cheeky-smokey/FUJISOKU-SRAM-Utility/docs/hardware.md

# ハードウェア仕様 / 接続

この資料は次の出典とスケッチを突き合わせてまとめています。

| 区分 | 出典 |
|---|---|
| MCP23S17 とカードの結線 | note「cheekysmokey」配線の記事 <https://note.com/cheekysmokey/n/nef1ee2754b83>（2026-04-09） |
| FUJISOKU カードのピン配置 | 同ピン配置の記事 <https://note.com/cheekysmokey/n/n0525462640a3>（2026-01-31） |
| スロット（修理とエクステンダー化） | 同スロットの記事 <https://note.com/cheekysmokey/n/nd67f79d83b57> |
| Arduino ピン、制御定数、アクセス手順 | `FUJISOKU_SRAM_COPY/config.h`、`hardware.ino` |

> **注意**
> - 記事の値は本文テキストから読み取ったものです。結線は原文の表と照合してください。
> - **v3.0（ブランチ `wo62256`）で ch7 ポート B の割り当てを変えました**（§7）。62256 をやめ、B0〜B3 を制御線、B4〜B7 をカードの A16〜A19（F32〜F35）にしています。**この割り当ては実機ではまだ確かめていません**（v2.8 までの割り当ては main ブランチ）。
> - 記事に書かれていない項目（電源、MCP23S17 のアドレス、部品の型番など）は、基板の作者に確認しました（§13）。基板の回路図ではありません。

## 1. 部品の構成

| 区分 | 部品 | 用途 | スケッチの設定（`config.h`） |
|---|---|---|---|
| 必須 | Arduino UNO R4 | 制御、PC との USB シリアル | - |
| 必須 | MCP23S17 × 2 | カードのアドレス（ch6）とデータ・制御線（ch7） | - |
| 必須 | FUJISOKU カードのスロット | カードの接続（§12） | - |
| オプション | SD カードモジュール | 本体だけでの `*.bin` の保存・照合・書き戻し | `USE_SD`（既定 0） |
| オプション | 20×4 キャラクタ LCD（I2C） | 本体での状態・進捗の表示。同じ内容は Web アプリにも出る | `USE_LCD`（既定 1） |
| オプション | SPI SRAM（Microchip 23LC512、/CS = D6） | 本体だけでのコピー・比較の一時置き場（カード ⇄ SPI SRAM、SPI SRAM ⇄ SD） | `USE_SPI_SRAM`（既定 1。起動時に自動検出） |
| 配線 | カードの検出（F37 /CARD DET → D2） | カードが入っているか。無ければカードを使う操作を止める（§6.1） | `USE_CARD_DET`（既定 1） |
| 配線 | 電池電圧（F2 BATT-DET → A2、A2 と GND の間に 1 MΩ） | カードの電池電圧を表示し、1.70 V 以下で「少ない」、0.50 V 以下で「電池なし」と警告（§6.1） | `USE_BATT_DET`（既定 1） |

カードの吸い出し・書き込み・比較は Web アプリ（PC）でできるので、**必須なのは Arduino UNO R4、MCP23S17 × 2、スロットだけ**です。SD と LCD を 0 にすれば、外部ライブラリも要りません。

- `USE_SD` は既定で 0 です。SD のコードが入らず、SdFat ライブラリも要りません。SD のコマンドは `ERR DISABLED` を返します（§10）。SD カードモジュールをつないだら 1 にします。
- カードの検出と電池電圧は、Arduino に線を 1 本ずつ足すだけです（§6.1）。配線しない基板では `USE_CARD_DET` / `USE_BATT_DET` を 0 にしてください（`USE_CARD_DET` が 1 のまま D2 を配線しないと、いつも「カードなし」になります）。
- `USE_LCD` が 1 でも、起動時に LCD が I2C に応答しなければ LCD には何も送らずに動きます。LCD をつながないなら 0 にすると、LiquidCrystal I2C ライブラリも要りません。
- `USE_SPI_SRAM` が 1 でも、起動時に SPI SRAM が応答しなければ、SPI SRAM を使う操作は `ERR NOSPI` を返します（§9.1）。つながないなら 0 にすると、SPI SRAM のコードが入らず、`ERR DISABLED` を返します。

## 2. 全体接続図

ハードウェア接続図

- Arduino UNO R4 が SPI マスタです。PC とは USB シリアル（115200 bps）でつながり、Web アプリ（`webapp/FSRAM-Utility.html`）やシリアル端末から操作します。
- カードのアドレス・データ・制御線は **MCP23S17 を 2 個**（ch6 = アドレス、ch7 = データ + 制御）使った GPIO エキスパンダ経由で駆動します。
- 破線の箱（SD カード、LCD、SPI SRAM）はオプション部品です。v1 の TFT（ILI9341）とタッチ（XPT2046）は使いません。

### 2.1 電源と信号レベル

| 項目 | 内容 |
|---|---|
| 電源電圧 | **5 V**（単一電源） |
| レベル変換 | **不要**。Arduino UNO R4、MCP23S17、カード、SPI SRAM（23LC512 は 2.5〜5.5 V）、LCD はすべて 5 V 系 |
| カードの電源ピン | F3・F36 が Vcc（5 V）、F1・F38 が GND。それぞれカードの内部でつながっている（§5） |
| SD カード（オプション） | SD カード自体は 3.3 V なので、5 V で使えるモジュール（3.3 V レギュレータとレベル変換付き）を使う。作者の基板もこのモジュール |

### 2.2 回路図（KiCad）

ここまでの結線をまとめた KiCad の回路図が [hardware/kicad/](../hardware/kicad/) にあります（`.kicad_sch` と A3 の PDF）。結線は `check_netlist.py` でこの文書の表と照らし合わせてあります。パスコン（C1〜C3 0.1 µF）と C4（10 µF、カードの電源）は回路図だけに入れた推奨部品です。

回路図

### 2.3 シールド基板（KiCad、ガーバー付き）

Arduino UNO R4 に重ねるシールド基板（2 層、68.6 × 53.3 mm、部品はすべてスルーホール・DIP）が [hardware/kicad/shield/](../hardware/kicad/shield/) にあります。MCP23S17 × 2、23LC512（オプション）、BATT-DET のプルダウン、SD・LCD 用のピンヘッダが載り、62256 は載せていません。カードは、スロットユニット（U-BOX から外したスロット + 変換基板 + L 型ボックスヘッダ、§12.2）を J1 のキー付き MIL メスソケットに直接挿してつなぎます。ソケットのキーは奥（U1 側）で、逆向きには挿さりません。部品表と注文のしかたは [hardware/kicad/README.md](../hardware/kicad/README.md#シールド基板arduino-uno-r4-用) を見てください。基板の銅のつながりは `check_netlist.py --shield` でこの文書の表と照らし合わせてあります。

シールド基板（表）

## 3. Arduino ピン割り当て

| ピン | 定義名 | 接続先 | 備考 |
|---|---|---|---|
| D13 / D12 / D11 | - | SCK / MISO / MOSI（MCP23S17・SPI SRAM・SD で共用） | アクセスごとに `SPI.beginTransaction()`（4 MHz、モード 0） |
| A4 / A5 | - | LCD の SDA / SCL（PCF8574 バックパック、オプション） | `Wire`、I2C アドレス `LCD_I2C_ADDR`（既定 `0x27`） |
| D7 | `PIN_CS_SD` | SD カード /CS（オプション） | SD を使う処理のたびにマウントし直す（§10）。`USE_SD` が 0 でも High にしておく（SD モジュールを付けたままでも SPI を邪魔しない） |
| D6 | `PIN_CS_SPI_SRAM` | SPI SRAM /CS（オプション） | SPI SRAM の /CS はここだけ（§9.1）。`USE_SPI_SRAM` が 0 でも High にしておく |
| D5 | `PIN_MCP_RESET` | MCP23S17 /RESET（p18、2 個共通） | 起動時に 1 ms Low |
| D4 | `PIN_CS_MCP` | MCP23S17 /CS（p11、2 個共通） | 2 個はハードウェアアドレス（6 と 7）で区別する |
| D3 | `PIN_MCP_INT` | 未接続 | 入力にしているだけ。MCP23S17 の INT はつながず、割り込みは使わない |
| D2 | `PIN_CARD_DET` | カードの /CARD DET（F37） | 内蔵プルアップの入力。カードが入ると Low（§6.1） |
| A2 | `PIN_BATT_DET` | カードの BATT-DET（F2）。A2 と GND の間に 1 MΩ | アナログ入力（12 ビット、0〜5 V）。電池電圧を測る（§6.1） |
| D0、D1、D8、D9、D10、A0、A1、A3 | - | 空き | D8〜D10 は v1 では TFT とタッチに使っていた |

v2.2 まで定義だけあった D1（`CS_FSRAM_512`、未使用）は削除しました。

**SPI の設定について**: SdFat は SPI を高速なクロックに設定したまま戻しません（UNO R4 の `endTransaction()` は何もしない）。設定なしの `SPI.transfer()` だと、直前に SD を使ったときのクロックで MCP23S17（上限 10 MHz）に送ってしまうため、すべての MCP23S17 / SPI SRAM へのアクセスを `SPI.beginTransaction(4 MHz)` で囲んでいます。

## 4. MCP23S17 × 2

### 4.1 結線（記事より）

| MCP23S17 のピン | 接続 |
|---|---|
| p12 SCK / p13 SI / p14 SO | SPI の SCK / MOSI / MISO |
| p11 /CS | D4 |
| p18 /RESET | D5 |
| GPA0〜GPA7 | p21〜p28 |
| GPB0〜GPB7 | p1〜p8 |

- チップは **ch6（アドレス）と ch7（データ + 制御）** の 2 個です。
- スケッチは ch0〜ch7 の 8 チャネルすべてを初期化しますが、使うのは ch6 と ch7 だけです。存在しないチャネルへの書き込みは無視されます。
- A2:A0 ピンはチャネル番号と同じに設定します（ch6 = `110`、ch7 = `111`）。スケッチもこの前提で、作者の基板もこの設定です。
- 電源は VDD = 5 V、VSS = GND（§2.1）。INT ピンは使いません（D3 は未接続）。

### 4.2 オペコード

`0 1 0 0 A2 A1 A0 R/W`。チャネル（= ハードウェアアドレス）ごとに `config.h` のマクロで作ります。

| 項目 | 定義名 | 値 |
|---|---|---|
| 書き込み | `MCP_OP_WRITE(ch)` | `0x40 + ch × 2`（ch6 = `0x4C`、ch7 = `0x4E`） |
| 読み出し | `MCP_OP_READ(ch)` | `0x41 + ch × 2`（ch6 = `0x4D`、ch7 = `0x4F`） |

### 4.3 初期化（`mcp_init()`）

1. D5 を 1 ms Low にしてリセット（`setup()`）。
2. IOCON（BANK=0 のアドレス `0x0A`）へ `0x8C`（`MCP_IOCON_VALUE` = BANK + HAEN + ODR）を、オペコード `MCP_OP_WRITE(0)` = `0x40` と `MCP_OP_WRITE(4)` = `0x48` で 2 回書く。以後は **BANK=1** のレジスタ配置を使う。
   - HAEN が無効なあいだ、A2 ピンが High のチップは、オペコードの A2 ビットも 1 でないと応答しません（MCP23S17 の癖）。ch6 / ch7 は A2 = 1 なので `0x48` が要ります。
3. ch0〜ch7 すべてで OLAT_A/B = `0x00`、IODIR_A/B = 入力、GPPU_A/B = 全ビットプルアップ。
4. `bus_idle()`: ch7 IODIR_A = 入力、ch6 IODIR_A/B = 入力、**ch7 GPIO_B = `0x0F`（全制御線 非選択、A16〜A19 = 0）を書いてから** ch7 IODIR_B = 出力。
   - v1 は IODIR_B を先に出力にしていたため、全制御線が一瞬 Low になっていました。v2 は値を先に書くので、この瞬間はありません。

`bus_idle()` は、すべての処理の終わり（成功・失敗・中断とも）と、PC からの `rd` `wr` `fill` の後にも呼ばれます。待機中のアドレス・データ線は入力（プルアップ）で、制御線はすべて非選択です。

### 4.4 レジスタ（BANK=1）

| レジスタ | 定義名 | アドレス |
|---|---|---|
| IODIR A / B（1 = 入力） | `MCP_IODIR_A` / `MCP_IODIR_B` | `0x00` / `0x10` |
| GPPU A / B | `MCP_GPPU_A` / `MCP_GPPU_B` | `0x06` / `0x16` |
| GPIO A / B | `MCP_GPIO_A` / `MCP_GPIO_B` | `0x09` / `0x19` |
| OLAT A / B | `MCP_OLAT_A` / `MCP_OLAT_B` | `0x0A` / `0x1A` |
| IOCON（リセット直後、BANK=0） | `MCP_IOCON_BANK0` | `0x0A` |

### 4.5 チャネルの役割

| ch | 役割 | ポート A | ポート B |
|---|---|---|---|
| 0〜5 | 初期化のみ（入力 + プルアップ） | - | - |
| 6 (`MCP_CH_ADDR`) | アドレスバス | A0〜A7 | A8〜A15 |
| 7 (`MCP_CH_DATA` / `MCP_CH_CTRL`) | データ + 制御 | D0〜D7（読むときは入力、書くときは出力） | 制御線 + A16〜A19（常に出力、§7） |

## 5. FUJISOKU カードのピン配置（記事より）

38 ピン（F1〜F38）。方向はカードから見た向きです。

| ピン | 信号 | 方向 |
|---|---|---|
| F1 | GND | - |
| F2 | BATT-DET | 出力 |
| F3 | Vcc | - |
| F4 | /CE1 | 入力 |
| F5 | CE2 | 入力 |
| F6 | /WE | 入力 |
| F7 | /OE | 入力 |
| F8〜F15 | D0〜D7 | 双方向 |
| F16〜F23 | A0〜A7 | 入力 |
| F24〜F31 | A8〜A15 | 入力 |
| F32 | A16 | 入力 |
| F33 | A17 | 入力 |
| F34 | A18 | 入力 |
| F35 | A19 | 入力 |
| F36 | Vcc | - |
| F37 | /CARD DET | 出力 |
| F38 | GND | - |

- F3・F36（Vcc）と F1・F38（GND）は、それぞれカードの内部でつながっています。スロットからは 5 V と GND を供給します（§2.1）。
- 記事のピン配置表には F28 の行がありません。結線の記事では F28 = A12 です。
- カード容量ごとの未接続ピン（記事）: 128 KB は A17〜A19、256 KB は A18〜A19、512 KB は A19 が NC。
- このカードはシルバー編機のパターンプロセッサ（PE1）が使い、PE1 は A15 までを出力して A16〜A19 は接続しない、と記事にあります。
- カード型番は Fujisoku BS32D1-A（32 KB）と推定されています（記事は公式情報ではないと明記）。
- 本体だけの処理（コピー・比較・消去・SD）は **0x0000〜0x7FFF（32 KB）** を扱います。PC（Web アプリの `rd` / `wr`）からは、アドレス線 A0〜A19 の範囲 **0x00000〜0xFFFFF（1 MB）** まで読み書きできます（v3.0 から。v2.4〜v2.8 は A0〜A17 の 256 KB）。
- A18・A19（F34・F35）は v3.0 から ch7 の GPB6・GPB7 で駆動します。512 KB・1 MB のカードも全体を読み書きできます（v2.8 までは MCP につながず GND に固定し、先頭の 256 KB だけでした）。
- 32 KB のカードは A15 以上がつながっていない（NC）ので、0x8000 以降を読むと先頭と同じ内容が、書くと先頭が上書きされます。Web アプリは 32 KB を超えて書く前に警告します。

## 6. MCP23S17 とカードの結線

MCP23S17 とカードの結線図

| 信号 | カードのピン | MCP | ポート | MCP のピン | 方向（MCP 側） |
|---|---|---|---|---|---|
| `D0`〜`D7` | F8〜F15 | ch7 | GPA0〜GPA7 | 21〜28 | 双方向 |
| `A0`〜`A7` | F16〜F23 | ch6 | GPA0〜GPA7 | 21〜28 | 出力 |
| `A8`〜`A15` | F24〜F31 | ch6 | GPB0〜GPB7 | 1〜8 | 出力 |
| `CE2` | F5 | ch7 | GPB0 | 1 | 出力 |
| `/OE` | F7 | ch7 | GPB1 | 2 | 出力 |
| `/CE1` | F4 | ch7 | GPB2 | 3 | 出力 |
| `/WE` | F6 | ch7 | GPB3 | 4 | 出力 |
| `A16` | F32 | ch7 | GPB4 | 5 | 出力 |
| `A17` | F33 | ch7 | GPB5 | 6 | 出力 |
| `A18` | F34 | ch7 | GPB6 | 7 | 出力 |
| `A19` | F35 | ch7 | GPB7 | 8 | 出力 |

- ch7 ポート B は v3.0 の割り当てです（§7）。A0〜A15 とデータは記事と同じですが、制御線と A16・A17 の位置は記事とも v2.8 とも違います。
- データ線は D0〜D7 = ch7 の GPA0〜GPA7 の順です（D2 = GPA2、D3 = GPA3）。記事の配線表で D2 と D3 がどちらも GPA3 に見えるのは誤記で、スケッチどおりが正しいことを作者に確認しました。
- A18・A19（F34・F35）は ch7 の GPB6・GPB7 につなぎます（v3.0）。BATT-DET（F2）と /CARD DET（F37）は MCP を通さず、Arduino の A2 と D2 に直接つなぎます（§6.1）。
- 電源は 5 V で、レベル変換は要りません。カードの Vcc（F3、F36）に 5 V、GND（F1、F38）に GND をつなぎます（§2.1）。

### 6.1 カードの検出と電池電圧（Arduino に直接つなぐ）

| 信号 | カード | Arduino | 設定 | 動き |
|---|---|---|---|---|
| /CARD DET | F37 | D2（`PIN_CARD_DET`） | `USE_CARD_DET`（既定 1）、`CARD_DET_ACTIVE_LOW`（既定 1） | 内蔵プルアップの入力。カードが入ると Low |
| BATT-DET | F2 | A2（`PIN_BATT_DET`）。**A2 と GND の間に 1 MΩ** | `USE_BATT_DET`（既定 1）、`BATT_NONE_MV`（既定 500）、`BATT_LOW_MV`（既定 1700）、`BATT_ADC_FULL_MV`（既定 5000） | アナログ入力で電池電圧を測る |

**カードの検出（D2）**
- 50 ms 同じ値が続いたら抜き差しとみなし、PC に `E CARD 1` / `E CARD 0` を送ります。LCD の待機画面の 2 行目は `Card:OK` / `Card:NONE` になります。
- カードが無いとき、カードを使うコマンド（`rd f`・`wr f`・`copy`・`cmp`・`erase f`・`sd save f` など、1 文字コマンドの `R` `C` `X` `B` `L` `V` `e`）は `ERR NOCARD No card in the slot` を返します。
- 処理の途中で抜かれたら、3 回続けて「無い」と読んだところで止め、`ERR NOCARD Card removed at 0x....` を返します。バスは待機状態に戻します。
- 向きが逆（カードが入ると High）の基板では `CARD_DET_ACTIVE_LOW` を 0 にします。

**電池電圧（A2）**
- **A2 と GND の間に 1 MΩ の抵抗をつけます。** つけないと、電池が無いとき BATT-DET の線が浮き、カードの中の漏れ電流で 3〜4 V に見えます（作者の基板で、電池なしで 3.6 V と表示された）。抵抗に流れる電流は 3 µA ほどで、本体に挿しているあいだだけです。
- 作者の基板（1 MΩ 付き）での実測: **電池なし 0.24 V、新品の電池 2.75 V**。
- 0.5 秒ごとに 8 回測って平均します（12 ビット、0〜5 V）。50 mV 以上変わったときと、警告の境目をまたいだときに `E BATT <mV>` を送ります。
- **0.50 V（`BATT_NONE_MV`）以下は「電池なし」（No battery）**とみなします。LCD は `Bat:NONE!`、4 行目を `! No card battery` にします。Web アプリは「なし」と出し、画面の上に「カードに電池が入っていません」の警告を出します（本体に挿しているあいだは本体の電源で中身が保たれますが、抜くと消えます）。
- **1.70 V（`BATT_LOW_MV`）以下で「少ない」（Low battery）と警告**します。LCD は電圧の後ろに `!` を付け、4 行目を `! Card battery low` にします。Web アプリは画面の上に警告を出します。
- 2 つの判定電圧は `config.h` の先頭（`USE_BATT_DET` のすぐ下）で変えられます。`BATT_NONE_MV` は `BATT_LOW_MV` より小さくしてください（逆にするとビルドが止まります）。
- カードが無いときは測りません（表示は消え、`status` は `batt=-`）。挿してから 0.1 秒後に測り直します。
- 電圧の基準は UNO R4 の 5 V です。表示がテスターの値とずれるときは、5 V ピンをテスターで測った値を `BATT_ADC_FULL_MV` に入れると合います。

**電池の種類と A2 の測定値（実測）**

カードに入れる電池は 2 種類（CR2016、BR2325）あります。A2 の測定値（Arduino の測定電圧）と、テスターで測った電池の電圧を並べると、電池の種類ごとに原点を通る直線に乗り、テスターの値のほうが 13〜21 % 高く出ます。

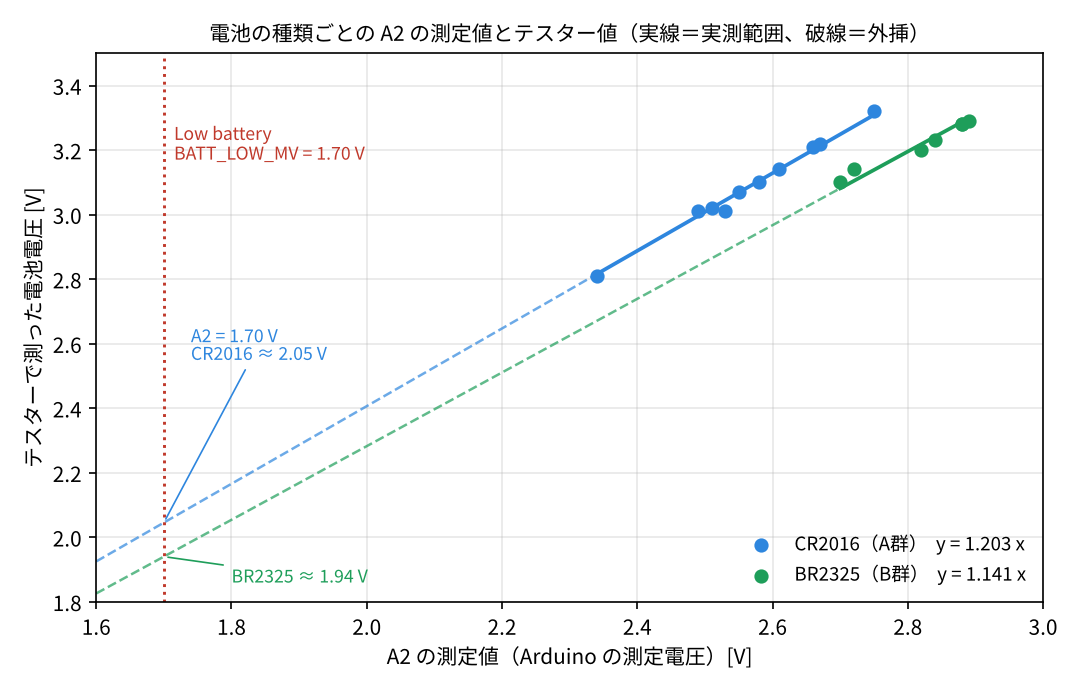
[picture p7: docs/images/battery-a2-vs-tester.png]
A2 の測定値とテスターで測った電池電圧の関係（CR2016 と BR2325）


**関係式**（x = A2 の測定値 [V]、y = テスターで測った電池電圧 [V]。原点を通る直線で近似）

| 群 | 電池 | A2 → テスター値 | テスター値 → A2 | 比（y ÷ x） | 実測との差（最大） | 点数 | 実測した x の範囲 |
|---|---|---|---|---|---|---|---|
| A 群 | CR2016 | **y = 1.203 x** | x = 0.831 y | 1.19〜1.21 | ±0.034 V | 10 | 2.34〜2.75 V |
| B 群 | BR2325 | **y = 1.141 x** | x = 0.876 y | 1.13〜1.15 | ±0.036 V | 7 | 2.70〜2.89 V |

- 「テスター値 → A2」の式は、「A2 → テスター値」の式の逆数です（1 ÷ 1.203 = 0.831、1 ÷ 1.141 = 0.876）。
- 実測した範囲は、A 群が B 群より低い電圧まで広がっています。B 群は 2.70〜2.89 V の狭い範囲だけなので、傾きの不確かさが大きく、低い電圧への外挿はそのぶんあやふやです。

**判定電圧の換算**（式からの外挿。実測した範囲の外にあるものは、実機で確かめていません）

| A2 の測定値 | CR2016（A 群）のテスター値 | BR2325（B 群）のテスター値 |
|---|---|---|
| 1.70 V（`BATT_LOW_MV`） | 約 2.05 V | 約 1.94 V |
| 1.50 V（以前の `BATT_LOW_MV`） | 約 1.80 V | 約 1.71 V |

| テスターで測った電池電圧 | CR2016（A 群）の A2 の測定値 | BR2325（B 群）の A2 の測定値 |
|---|---|---|
| 2.00 V | 約 1.66 V | 約 1.75 V |

実測値（A2 の測定値 → テスターの測定値、単位 V）:

| 電池 | A2 の測定値 → テスター値 |
|---|---|
| CR2016 | 2.34→2.81、2.49→3.01、2.51→3.02、2.53→3.01、2.55→3.07、2.58→3.10、2.61→3.14、2.66→3.21、2.67→3.22、2.75→3.32 |
| BR2325 | 2.70→3.10、2.72→3.14、2.82→3.20、2.84→3.23、2.88→3.28（2 回）、2.89→3.29 |
| カードの中身が消えていた状態 | 0.40→0.33、0.52→0.30、0.53→0.53 |

- 実測した範囲は、A2 の測定値で 2.34〜2.89 V です。それより低い範囲（Low battery の 1.70 V 付近）は測っていません。
- **Low battery（A2 の測定値 1.70 V 以下）は、テスターで測った電池の電圧では約 2 V（CR2016 で約 2.05 V、BR2325 で約 1.94 V）にあたります。** 数値は式からの外挿です。ここまで下がったら、電池の交換を促します（LCD の `!` と `! Card battery low`、Web アプリの警告）。
- **No battery（A2 の測定値 0.50 V 以下）は電池なしと判定できます。** カードの中身が消えていた 3 点は、A2 の測定値が 0.40〜0.53 V でした。0.52 V と 0.53 V は 0.50 V 以下に入らないため、「電池なし」ではなく「少ない」と判定されます。
- スケッチは A2 の測定値をそのまま表示し、電池の種類による補正はしません。
- テスターの値との差は電池の種類で比が違うため、`BATT_ADC_FULL_MV` では 2 種類の電池をそろえて合わせられません。

## 7. ch7 ポート B（制御線と A16〜A19）

v3.0（ブランチ `wo62256`）の割り当てです。62256 をやめて空いた B2 を /CE1 に回し、B4〜B7 をカードの A16〜A19 にしました。**実機ではまだ確かめていません**（PC 上のシミュレータとテストでは確認済み）。

| ビット | 信号 | 接続先 |
|---|---|---|
| B0 | CE2（High で選択） | F5 |
| B1 | /OE | F7 |
| B2 | /CE1 | F4 |
| B3 | /WE | F6 |
| B4 | A16 | F32 |
| B5 | A17 | F33 |
| B6 | A18 | F34 |
| B7 | A19 | F35 |

v2.8 までの割り当て（main ブランチ）は、B0 = CS2（62256 の /CS と共用）、B1 = /OE、B2 = 62256 の /OE、B3 = /WE、B4 = /CE1、B5 = 未使用、B6 = A16、B7 = A17 で、A18・A19 は GND に固定していました。この割り当ては作者の基板で動作確認済みです。v2.8 の基板を v3.0 で使うには、ch7 の GPB2・GPB4〜GPB7 の配線をつなぎ直す必要があります。

配線の記事の表（B0 = /CE1、B1 = CE2、B2 = /WE、B3 = /OE、B4/B5 = NC）とも違います。

SPI SRAM の /CS は Arduino の D6 につなぎます（MCP23S17 にはつながない）。

### 7.1 制御定数（`config.h`）

各ビットに名前を付け、状態ごとの値はそこから組み立てています。`hardware.ino` の `static_assert` で値を確かめています。

| ビット | 定義名 | 値 |
|---|---|---|
| B0 | `CTRL_CS2` | `0x01` |
| B1 | `CTRL_CARD_nOE` | `0x02` |
| B2 | `CTRL_CARD_nCE1` | `0x04` |
| B3 | `CTRL_nWE` | `0x08` |
| B4〜B7 | `CTRL_ADDR_HI` | `0xF0`（A16〜A19。`CTRL_ADDR_HI_SHIFT` = 12） |

| 状態 | 定義名 | 値 | 内容 |
|---|---|---|---|
| 待機 | `CTRL_IDLE` | `0x0F` | /CE1 = H、CE2 = H、/OE = H、/WE = H（非選択） |
| カード選択 | `CTRL_CARD_SELECT` | `0x0B` | /CE1 = L、CE2 = H |
| カード解放 | `CTRL_CARD_RELEASE` | `0x0E` | /CE1 = H、CE2 = L（1 バイトごとの後始末。CE2 も下げて二重に非選択にする） |

- 読み出しは選択値から `/OE`（B1）を、書き込みは `/WE`（B3）を落として作ります（例: カードの読み出し `0x0B & ~0x02` = `0x09`、書き込み `0x0B & ~0x08` = `0x03`）。
- A16〜A19 は `bus_select()` が `(address >> 12) & 0xF0` で B4〜B7 に重ねて出力します（0x00000〜0x0FFFF では 0）。A15 は ch6 の GPB7 です。

## 8. アクセスシーケンス

PC 上のシミュレータ（`test/sim`、`FSU_SIM_TRACE=1`）で記録した、`rd f 0x1234 2` と `wr f 0x1234 5A6B` の MCP23S17 へのアクセスです。**実機の測定ではありません。** どのアクセスも `SPI.beginTransaction()` で囲みます。

v2.3 では、1 バイトごとの手順（選択 → /OE や /WE のパルス → 解放）は v1 と同じ順のまま、次の 2 点で SPI の転送を減らしました（カード全域の読み込みは、シミュレータの時間で約 10.4 秒 → 約 7.3 秒）。

- バスの向き（IODIR）は、向きが変わるときだけ書く（`bus_set_dir()`。`bus_idle()` で待機に戻る）。
- 直前に自分で書いた制御値を OLAT_B から読み戻していたのをやめ、値を覚えておく。

### 8.1 読み出し（1 バイト 7 回。最初のバイトだけ向きの設定 3 回が先に入る）

| # | ch | レジスタ | 値 | 内容 |
|---|---|---|---|---|
| (1) | 6 | IODIR_A | `0x00` | A0〜A7 を出力（最初だけ） |
| (2) | 6 | IODIR_B | `0x00` | A8〜A15 を出力（最初だけ） |
| (3) | 7 | IODIR_A | `0xFF` | D0〜D7 を入力（最初だけ） |
| 1 | 6 | GPIO_A | `0x34` | A0〜A7 |
| 2 | 6 | GPIO_B | `0x12` | A8〜A15 |
| 3 | 7 | GPIO_B | `0x0B` | カード選択（+ A16〜A19） |
| 4 | 7 | GPIO_B | `0x09` | /OE = L（B1） |
| 5 | 7 | GPIO_A 読み | データ | データバスを読む |
| 6 | 7 | GPIO_B | `0x0B` | /OE = H |
| 7 | 7 | GPIO_B | `0x0E` | カード解放 |

### 8.2 書き込み（1 バイト 7 回。最初のバイトだけ向きの設定 3 回が入る）

| # | ch | レジスタ | 値 | 内容 |
|---|---|---|---|---|
| 1 | 7 | GPIO_A | `0x5A` | データを出力ラッチへ（**先に**値を決めてから出力にする） |
| (2) | 6 | IODIR_A / IODIR_B | `0x00` | アドレスを出力（最初だけ） |
| (3) | 7 | IODIR_A | `0x00` | D0〜D7 を出力（最初だけ） |
| 2 | 6 | GPIO_A | `0x34` | A0〜A7 |
| 3 | 6 | GPIO_B | `0x12` | A8〜A15 |
| 4 | 7 | GPIO_B | `0x0B` | カード選択 |
| 5 | 7 | GPIO_B | `0x03` | /WE = L（B3） |
| 6 | 7 | GPIO_B | `0x0B` | /WE = H（この立ち上がりで書き込まれる） |
| 7 | 7 | GPIO_B | `0x0E` | カード解放 |

処理の最後に `bus_idle()` が IODIR を入力に戻し、制御線を `0x0F` にします。

v2.2 までは「/WE = L → データを出す → /WE = H」の順で、/WE が Low のあいだに前のバイトの値が一瞬カードに書かれていました（最後に正しい値で上書きされるので結果は同じ）。v2.3 はデータを先に出すので、この途中の値はありません。

シミュレータでは、カードの SRAM は /WE の立ち上がりでデータを取り込むモデルにしてあり、「書き込み中にアドレスやデータが変わる」「/OE と /WE が同時に Low」「データバスの衝突」がないことをテストで確かめています。

## 9. SPI SRAM（オプション）

### 9.1 SPI SRAM（オプション、本体だけでの処理の一時置き場）

`config.h` の `USE_SPI_SRAM`（既定 1）で使います。カードの吸い出し・書き込み・比較は Web アプリ（PC）でできるので、SPI SRAM は本体だけでのコピー（`copy f s` / `R`、`copy s f` / `C`）・比較（`cmp` / `X`）と、SPI SRAM ⇄ SD（`S` / `W`）に使うだけです。

| 項目 | 値 |
|---|---|
| デバイス | Microchip 23LC512（512K ビット = 64 KB、2.5〜5.5 V。5 V で使う） |
| /CS | **Arduino D6**（`PIN_CS_SPI_SRAM`）。MCP23S17 にはつながない |
| SCK / MOSI / MISO | D13 / D11 / D12（MCP23S17・SD と共用） |
| アドレス | 16 ビット（2 バイト） |
| READ / WRITE | `0x03` / `0x02`（`SRAM23_READ` / `SRAM23_WRITE`） |
| モードレジスタ READ / WRITE | `0x05` / `0x01`（`SRAM23_RDMR` / `SRAM23_WRMR`） |
| モード | バイト `0x00`、ページ `0x80`、シーケンシャル `0x40`（電源投入時） |
| 利用範囲 | 本体だけの処理は 0x0000〜0x7FFF（32 KB）。PC からの `rd s` / `wr s` は 0x0000〜0xFFFF（64 KB） |
| 関数 | `read_spi_sram_byte()` / `write_spi_sram_byte()`、`spi_sram_read_mode()`、`spi_sram_init()` |
| コマンドの対象 | `s` |

- 起動時に `spi_sram_init()` で **SPI SRAM があるかを確かめます**。モードをバイト（`0x00`）→ シーケンシャル（`0x40`）と書いて、そのたびに読み戻します。チップが無いと MISO は張り付くか浮いているので、2 つとも読み戻せることはありません。最後はシーケンシャル（電源投入時と同じ）に揃えるので、Arduino だけリセットしても前の設定は残りません。
- 見つからなかったときは、SPI SRAM を使う操作が `ERR NOSPI SPI SRAM not found` を返し、`hello` は `spisram=none`、起動メッセージは `SPI SRAM none` になります。自己診断（`test`）は見つからなくても実行でき、そのときに探し直します（起動後につないだ場合も認識）。
- `USE_SPI_SRAM` を 0 にすると SPI SRAM のコードが入らず、対象 `s` と `R` `C` `X` `E` `S` `W` `T` は `ERR DISABLED` を返します。D6 は High のままです。
- 配線の確認は自己診断（Web アプリの「SPI SRAM・診断」、または `test`）でできます。モードレジスタが `40` なら応答あり、`FF` なら応答なし（/CS・MISO・電源を確認）です。`status` の `spi=` にも同じ値が出ます。
- v2.2 までの `config.h` は `MODE_RW_PAGE` と `MODE_RW_SEQ` の値が逆でした（データシートではページ `0x80`、シーケンシャル `0x40`）。v2.3 で直しました。

### 9.2 62256（v3.0 では使わない）

v2.8 までは、動作確認用の並列 SRAM 62256 をカードと同じバスにつなぎ、コマンドの対象 `p` として使えました（`USE_SRAM62256`）。v3.0（ブランチ `wo62256`）では、ch7 の GPB2 を /CE1 に、GPB4〜GPB7 を A16〜A19 に回すため 62256 をやめました。対象 `p` と `test p` は `ERR ARG` を返します。62256 を使う場合は main ブランチ（v2.8）を使います。

## 10. SD カード（オプション）

| 項目 | 内容 |
|---|---|
| 設定 | `USE_SD`（既定 0。使うときは 1） |
| ライブラリ | SdFat（Bill Greiman、v2 系）。`USE_SD` が 1 のときだけ必要 |
| 接続 | SPI（D13 / D12 / D11）、/CS = D7 |
| 用途 | PC を使わずに、カード ⇄ SD の保存・照合・書き戻し（Web アプリの「SD カード」タブ、または `sd` コマンド・`B` `L` `V`） |

`USE_SD` が 0 のときは、SD のコード（`storage.ino` と SD の処理）がコンパイルされません。`sd` `sdcheck` と 1 文字コマンドの `B` `L` `V` `S` `W` は `ERR DISABLED` を返し、LCD の待機画面は `SD:off`、Web アプリは SD のタブを隠します。

`USE_SD` が 1 のとき:

- SdFat（v2）を使い、ルートの `*.bin`（32,768 バイト）を扱います。既定のファイル名は `fujisoku.bin`。
- SD を使う処理を始めるたびにマウントし直すので、**処理の合間なら抜き差しできます**。起動時に SD が無くても止まりません。
- 待機中は 1.5 秒ごとにカードの応答を確かめ、抜かれたら LCD と PC に知らせます（`E SD 0`）。カードが無いときの `SD.begin()` は約 2 秒かかるため、挿したことの自動検出はしません。次の SD 処理か「SD カードを確認」（`sdcheck`）で認識します。
- UNO R4 の SdFat は `SD.end()` で共有の SPI ごと止めるので、スケッチは直後に SPI を動かし直します（MCP23S17 と SPI SRAM が使えなくなるのを防ぐ）。
- バックアップは一時ファイル `FSU_TMP.TMP` に書いてから名前を付け替えます。途中で失敗・中断・SD が抜けても、前のバックアップは残ります。

## 11. LCD（オプション、20 文字 × 4 行、I2C）

| 項目 | 値 |
|---|---|
| モジュール | HD44780 互換の 20×4 キャラクタ LCD + PCF8574 I2C バックパック |
| 接続 | 5V、GND、SDA = A4、SCL = A5 |
| I2C アドレス | `LCD_I2C_ADDR`（既定 `0x27`。作者の基板はこの値で動作確認済み。ほかのバックパックでは `0x3F` のこともある） |
| ライブラリ | LiquidCrystal I2C（Frank de Brabander）。`USE_LCD` が 0 なら不要 |
| 設定 | `USE_LCD`（既定 1）、`LCD_I2C_ADDR` |

- 起動時に `LCD_I2C_ADDR` へ I2C で呼びかけ、応答がなければ LCD は無いものとして、以後 LCD には何も送りません（UNO R4 の Wire は応答がなくても最大 0.1 秒で戻るので、起動は止まりません）。
- LCD の有無にかかわらず、本体は 20×4 の表示内容を持ち続けます。Web アプリは `lcd on` でその内容を受け取り、同じ画面を描きます。

表示内容は [specification.md §8](specification.md#8-表示lcd-と-web-アプリ) を参照してください。バックパックの半固定抵抗でコントラストを調整しないと文字が見えないことがあります。

## 12. スロット（記事より）

スロットの記事は、パターンプロセッサ（PE1）の壊れたスロットを修理し、リボンケーブルでつなぐ「エクステンダー」にした内容です。

- フジソク製のメモリスロットは 38 ピンで、もとのピン配列は ZIP。
- 使った部品: 汎用リボンケーブル用の 40 ピン 2 列ヘッダー（ピンを曲げて取り付け、不要なピンはカット）、ハーフピッチの 38 ピンヘッダー（壊れたスロットから抜いて修復・再組立）、秋月の 10 ピン 2.54 mm ピッチ（2×5）⇔ 1.27 mm ピッチ（1×10）変換基板、ケース用のユニバーサル基板。
- 1 番ピンの位置: 変換基板の表裏で、2 列ヘッダーの 1 番ピンが上段か下段かが決まる。PE1 の ZIP 配列に 2 列ヘッダーを付けると 1 番ピンは下段になる。記事は、変換基板の表裏を通常と逆にして下段を 1 番ピンにする方法を勧めています。
- ケーブルを延長しても、信号の遅れやノイズは問題にならなかったとあります。
- カードが壊れた場合は、リボンケーブル用ヘッダーに 62256 などの市販 SRAM を付けて代用できる、ただしアドレスデコードとバッテリーバックアップの回路が別に要る、とあります。

記事にはスロットから MCP23S17 への配線先は書かれていません。本ツールの結線は §6 です。

### 12.1 参考写真（作者の基板）

秋月電子の 10 ピン 2.54 mm ピッチ（2×5）⇔ 1.27 mm ピッチ（1×10）変換基板（上）と、それを 4 枚使ってスロットのピンを 40 ピン 2 列ヘッダーにつないだところ（下）です。

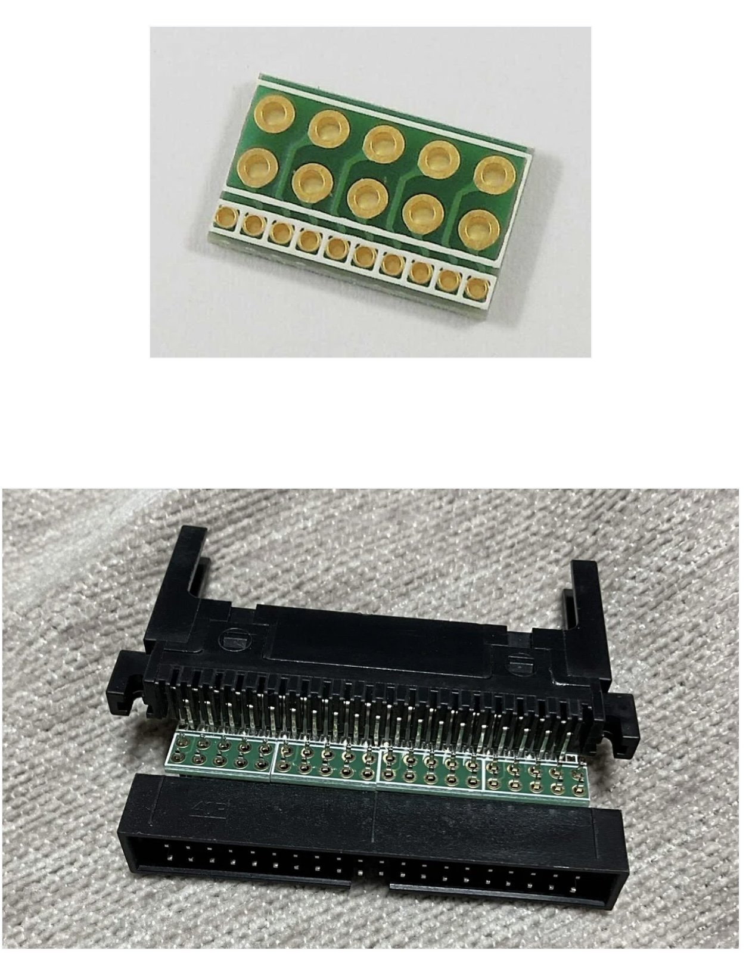
[picture p8: docs/images/slot-adapter-akizuki.jpg]
10 ピン 2.54 mm ⇔ 1.27 mm 変換基板と、スロットへの取り付け


ユニバーサル基板にスロットを固定し、カード（STITCH PATTERNS 32KB）を挿したところです。下の 40 ピン 2 列ヘッダーで MCP23S17 側へつなぎます（シールド基板では、L 型ボックスヘッダを付けたスロットユニットを J1 に直接挿します。§12.2）。

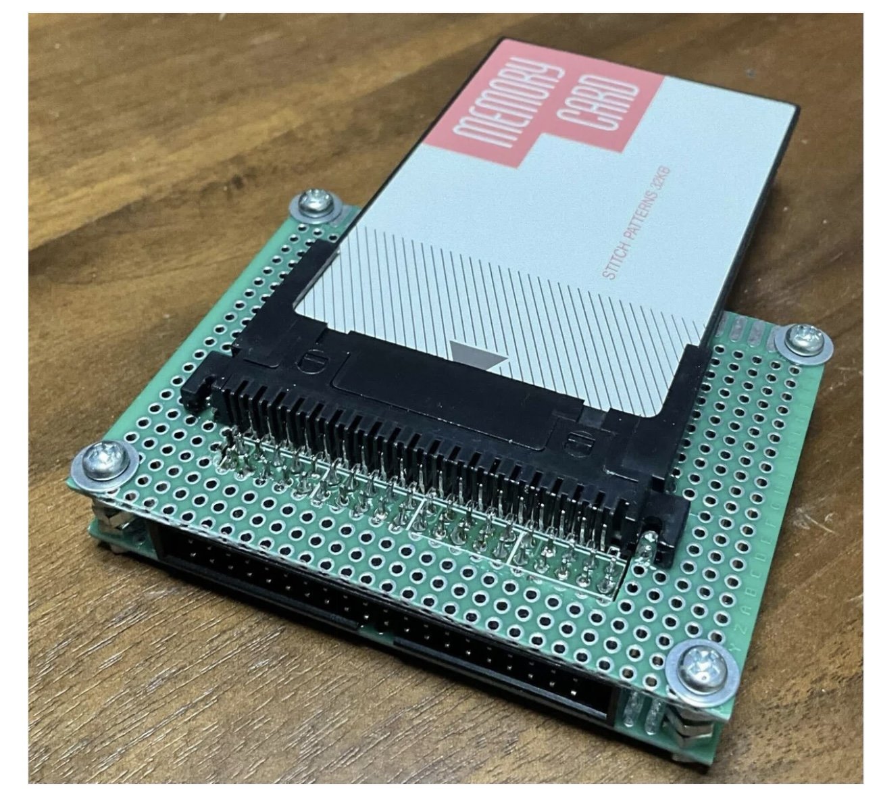
[picture p9: docs/images/slot-extender.jpg]
ユニバーサル基板に組んだスロットとカード


### 12.2 スロットユニット（作者に確認）

FUJISOKU のカードスロットは製造中止で手に入らないため、U-BOX から外したスロットを使います。スロットの足（ZIP 配列）を 1 列にそろえて、秋月電子の 2.54 mm（2×5）⇔ 1.27 mm（1×10）変換基板 4 枚の 1.27 mm の穴に挿し、2×5 の穴に **L 型（ライトアングル）のキー付きボックスヘッダ 2×20** を付けます。変換基板は表裏を通常と逆にして、ヘッダの下段（変換基板に近い列、偶数ピン）に F1 が来るようにします。

- **シールドにつなぐ**: シールド基板の J1（キー付き MIL メスソケット、キーは奥 = U1 側）に直接挿します。ボックスヘッダの切り欠きにソケットのキーが入るので、逆向きには挿さりません。挿した向きは、変換基板が手前（Arduino の電源ヘッダ側）、カードのラベル面が奥です。
- **U-BOX につなぐ**: U-BOX の CN2 に、足を ZIP 配列に曲げたボックスヘッダを付け、ストレートの 40 芯リボンケーブル（両端 IDC ソケット、1 番どうしがつながるもの）でつなぎます。CN2 の 1 番（F1）はボックスヘッダの 2 番（下段）に来るので、スロットユニットも 2 番 = F1 にしています。
- 切り欠き（キー）の位置は製品によって違うことがあります。買ったボックスヘッダとソケットで、正しい向きのときだけ挿さることを確かめてください。

ヘッダのピンとカードのピンの対応は次のとおりです。1.27 mm ピッチ 1 列のスロットのピンを、2.54 mm ピッチ 2 列に交互に振り分けた形です。

| ヘッダのピン | 1 | 2 | 3 | 4 | 5 | 6 | 7 | 8 | … | 35 | 36 | 37 | 38 | 39 | 40 |
|---|---|---|---|---|---|---|---|---|---|---|---|---|---|---|---|
| カードのピン | F2 | F1 | F4 | F3 | F6 | F5 | F8 | F7 | … | F36 | F35 | F38 | F37 | 空き | 空き |

奇数ピン 2k−1 = F2k、偶数ピン 2k = F2k−1（k = 1〜19）です。F34（A18、33 番）と F35（A19、36 番）は、v3.0 からシールド基板の U2（ch7）GPB6・GPB7 につながります。

## 13. 確認事項

記事に書かれていなかった項目も含め、次のとおり確定しています（基板の作者に確認）。

| 項目 | 結果 |
|---|---|
| 使用ボード | Arduino UNO R4 |
| 実機での動作 | Arduino UNO R4 と作者の基板で確認済み（v2.8。D2 のカード検出、A2 の電池電圧と電池なしの検出を含む）。**v3.0（ブランチ `wo62256`）の ch7 ポート B の新しい割り当てと A18・A19 は未確認** |
| A2 のプルダウン | A2 と GND の間に 1 MΩ。電池なしで 0.24 V、新品の電池で 2.75 V（実測） |
| 電池の種類 | CR2016 と BR2325。テスターで測った電池電圧と A2 の測定値の比（テスター値 ÷ A2 の測定値）は、CR2016 が約 1.20、BR2325 が約 1.14（実測。§6.1） |
| 電源電圧 | 5 V（§2.1） |
| レベル変換 | 不要（すべて 5 V 系） |
| カードの電源ピン | F3・F36 = Vcc（5 V）、F1・F38 = GND。カードの内部でそれぞれつながっている |
| MCP23S17 の数 | 2 個（ch6、ch7） |
| MCP23S17 の A2:A0 | チャネル番号と同じ（ch6 = `110`、ch7 = `111`）。スケッチどおり |
| D5 / D4 | MCP23S17 の /RESET（p18）/ /CS（p11） |
| D3（`PIN_MCP_INT`） | 未接続。割り込みは使わない |
| D2（`PIN_CARD_DET`） | カードの /CARD DET（F37）。カードの検出に使う（§6.1） |
| A2（`PIN_BATT_DET`） | カードの BATT-DET（F2）と、GND への 1 MΩ。電池電圧を測り、1.70 V 以下で「少ない」、0.50 V 以下で「電池なし」（§6.1） |
| カードのピン配置 | §5 |
| カードの F32〜F35（A16〜A19） | ch7（U2）の GPB4〜GPB7（v3.0。§6、§7）。カードは 1 MB まで |
| カードスロット | U-BOX から外したもの（FUJISOKU のスロットは製造中止）。変換基板 4 枚（表裏逆）と L 型のキー付きボックスヘッダ 2×20 でスロットユニットにする（§12.2） |
| スロットユニットの 40 ピン | 1 番 = F2、2 番 = F1（下段）、3 番 = F4、4 番 = F3 … 37 番 = F38、38 番 = F37。39・40 番は空き（§12.2） |
| シールドとの接続 | J1 のキー付き MIL メスソケット（基板用 40P、キーは奥 = U1 側）にスロットユニットを直接挿す |
| U-BOX との接続 | CN2 に足を ZIP 配列に曲げたボックスヘッダを付け、ストレートの 40 芯リボンケーブルでつなぐ。CN2 の 1 番（F1）がヘッダの 2 番 |
| データ線 | D0〜D7 = ch7 GPA0〜GPA7（D2 = GPA2、D3 = GPA3）。スケッチどおりで、記事の配線表の D2/D3 は誤記 |
| ch7 ポート B | B0 CE2、B1 /OE、B2 /CE1、B3 /WE、B4〜B7 A16〜A19（v3.0。§7） |
| SPI SRAM | Microchip 23LC512（64 KB）。/CS は Arduino D6（MCP23S17 にはつながない） |
| SD カードモジュール | 5 V で使えるもの（3.3 V レギュレータとレベル変換付き）。/CS は D7 |
| LCD | 20×4 キャラクタ LCD（I2C、オプション）。I2C アドレスは `0x27`（スケッチの既定値で動作確認済み）。TFT とタッチは使わない |
| 部品の区分 | 必須は MCP23S17 × 2 とスロット。SD カード、LCD、SPI SRAM はオプション（§1）。62256 は v3.0 では使わない |

まだ分からない項目はありません。
