cheeky-smokey/FUJISOKU-SRAM-Utility/docs/specification.md

# ソフトウェア仕様（スケッチ v3.0）

対象: `FUJISOKU_SRAM_COPY/`（`FSU_VERSION` = 3.0、ブランチ `wo62256`）。配線は [hardware.md](hardware.md)、PC との通信は [protocol.md](protocol.md)、Web アプリは [webapp.md](webapp.md) を参照してください。

## 1. 概要

FUJISOKU SRAM カード（基本は 32KB、0x0000〜0x7FFF。PC からは 1MB の 0xFFFFF まで）を、次の相手との間でコピー・照合します。

| 相手 | 操作する場所 |
|---|---|
| PC のファイル | Web アプリ（`rd` / `wr` で PC 側が処理し、本体は読み書きだけ）。**カードの吸い出し・書き込み・比較の基本はこれ** |
| SD カードの `*.bin`（オプション） | 本体（`sd save` / `sd load` / `sd verify`、1 文字コマンド `B` `L` `V`） |
| SPI SRAM（オプション、一時置き場） | 本体（`copy` / `cmp` / `erase`、1 文字コマンド `R` `C` `X` `E`） |

本体にボタンは無く、操作はすべて PC から行います。状態と進捗は 20×4 の画面に表示し、同じ内容を LCD（オプション）と Web アプリに出します。

## 2. ソース構成

Arduino IDE ではフォルダ内の `.ino` がタブとして開かれ、メインのファイルを先頭に、残りを名前順につないで 1 つのプログラムとしてビルドされます。

| ファイル | 内容 |
|---|---|
| `FUJISOKU_SRAM_COPY.ino` | ライブラリの読み込み（LCD はオプションに応じて）、グローバル変数、`setup()`、`loop()` |
| `card.ino` | カードの抜き差し（/CARD DET = D2、`E CARD`）と電池電圧（BATT-DET = A2、`E BATT`）。処理中にカードが抜かれたかの確認 |
| `config.h` | **オプション部品の選択**（§3）、設定値、ピン（`PIN_*`）、MCP23S17 のレジスタ（`MCP_*`）、制御線のビットと状態（`CTRL_*`）、SPI SRAM のコマンド（`SRAM23_*`） |
| `hardware.ino` | MCP23S17 のレジスタ読み書き（`mcp_read()` / `mcp_write()`）、`mcp_init()` / `bus_idle()`、バスの向きの管理、カード・SPI SRAM の 1 バイト読み書き、`spi_sram_init()` / `spi_sram_read_mode()` |
| `storage.ino` | SD カードの状態管理（マウント、生存確認、抜けの検出）、ファイル名の組み立て、一覧。`USE_SD` のときだけ |
| `operations.ino` | 処理の枠組み（開始・段階・進捗・終了・中断）と各処理（コピー、比較、消去、SD 保存・書き込み・照合、自己診断）。SD の処理は `USE_SD` のときだけ |
| `protocol.ino` | シリアルの行の受信、コマンドの振り分け、`rd` / `wr` / `fill`、PC 主導の表示（`ui`） |
| `lcd_ui.ino` | 画面（待機・進捗・結果）、LCD の検出と差分だけの書き換え、自作文字、PC への画面送信（`lcd`） |

## 3. 部品の構成とオプション

### 3.1 必須とオプション

| 区分 | 部品 | 設定 |
|---|---|---|
| 必須 | MCP23S17 × 2、FUJISOKU カードのスロット | - |
| オプション | SD カード（本体だけでの保存・照合・書き戻し） | `USE_SD` |
| オプション | 20×4 キャラクタ LCD（I2C） | `USE_LCD` |
| オプション | SPI SRAM（本体だけでのコピー・比較の一時置き場） | `USE_SPI_SRAM` |
| 配線 | カードの検出（F37 /CARD DET → D2） | `USE_CARD_DET` |
| 配線 | カードの電池電圧（F2 BATT-DET → A2） | `USE_BATT_DET` |

カードの吸い出し・書き込み・比較は Web アプリでできるので、SD カードと LCD はなくても使えます。既定の構成は SD カードなし（`USE_SD` = 0）、LCD と SPI SRAM はあり（どちらも起動時に探し、見つからなければ使わない）です。62256 は v3.0 で使わなくなりました（[hardware.md §9.2](hardware.md#92-62256v30-では使わない)）。

### 3.2 `config.h` のオプション

```c
#define USE_SD 0          // SD カード。1 で SD のコードを入れる (SdFat が要る)
#define USE_LCD 1         // 20x4 キャラクタ LCD (I2C)。0 で LCD のコードとライブラリを外す
#define USE_SPI_SRAM 1    // SPI SRAM。0 で SPI SRAM のコードを外す (1 でも見つからなければ使わない)
#define USE_CARD_DET 1    // カードの検出 (D2)。配線しない基板では 0
#define USE_BATT_DET 1    // カードの電池電圧 (A2、GND へ 1 MΩ)。配線しない基板では 0
```

| 設定 | 1 のとき | 0 のとき |
|---|---|---|
| `USE_SD` | 本体だけでの SD 保存・照合・書き戻し（§7）。起動時にカードが無くても、合間に抜き差ししても動く | SD のコード（`storage.ino`、SD の処理、`SdFat` の読み込み）を入れない。`sd` `sdcheck` と `B` `L` `V` `S` `W` は `ERR DISABLED`。`status` は `sd=-`、待機画面は `SD:off` |
| `USE_LCD` | 起動時に LCD を探し、見つかれば表示する（見つからなければ LCD には送らない） | LCD のコードを入れない。LiquidCrystal I2C と Wire を読み込まない |
| `USE_SPI_SRAM` | 起動時に SPI SRAM を探し（`spi_sram_init()`）、見つかれば対象 `s` と `R` `C` `X` `E` `S` `W` が使える。見つからなければそれらは `ERR NOSPI`。`test` は見つからなくても実行し、探し直す | SPI SRAM のコードを入れない。対象 `s` と `R` `C` `X` `E` `S` `W` `T` は `ERR DISABLED`。`status` は `spi=-` |
| `USE_CARD_DET` | D2 でカードの有無を見る。無ければカードを使う操作は `ERR NOCARD`、処理中に抜かれたら止める（§6.4） | いつもカードが入っているものとして扱う。`status` は `card=-` |
| `USE_BATT_DET` | A2 で電池電圧を測り、LCD と Web アプリに出す。`BATT_LOW_MV` 以下で「少ない」、`BATT_NONE_MV` 以下で「電池なし」と警告（§6.4） | 測らない。`status` は `batt=-` |

LCD の設定にかかわらず、本体は画面の内容を持ち続けるので、Web アプリには同じ画面が出ます。`hello` の応答（`lcd=20x4|none`、`sdcard=1|0`、`spisram=ok|none|off`）で、PC は構成を知ることができます。Web アプリは `sdcard=0` なら SD のタブを隠し、`spisram` が `ok` でなければ SPI SRAM の操作を隠します（`none` のときは自己診断だけ出す）。

SD と LCD を 0 にすると、外部ライブラリなしでビルドできます。

各設定は `#ifndef` で囲んであるので、ビルド時に `-DUSE_SD=0` のように外から変えることもできます（テストではこれを使っています）。

D7（SD の /CS）と D6（SPI SRAM の /CS）は、使わない設定でも出力・High にします。モジュールを付けたままでも、SPI の MISO を邪魔しません。

## 4. ビルド

| 項目 | 内容 |
|---|---|
| ボード | Arduino UNO R4（Minima / WiFi） |
| ライブラリ | `USE_SD` が 1 なら SdFat（Bill Greiman、v2 系）、`USE_LCD` が 1 なら LiquidCrystal I2C（Frank de Brabander）。どちらも 0 なら外部ライブラリは不要 |
| 標準ライブラリ | SPI（`USE_LCD` が 1 のときは Wire も） |

### 4.1 設定値（`config.h`）

| 定義 | 既定値 | 内容 |
|---|---|---|
| `USE_SD` | `0` | §3.2 |
| `USE_LCD` | `1` | §3.2 |
| `USE_CARD_DET` / `USE_BATT_DET` | `1` / `1` | §3.2 |
| `CARD_DET_ACTIVE_LOW` | `1` | /CARD DET はカードが入ると Low（逆の基板では 0） |
| `BATT_NONE_MV` | `500` | これ以下なら「電池なし」（No battery）[mV]。A2 の 1 MΩ で、電池が無いと約 0.24 V になる |
| `BATT_LOW_MV` | `1700` | これ以下なら「少ない」（Low battery）[mV]。`BATT_NONE_MV` より大きくする（逆ならビルドが止まる）。新品の電池は約 2.75 V |
| `BATT_ADC_FULL_MV` | `5000` | A2 の測定範囲 [mV]（UNO R4 の 5 V）。5 V ピンの実測値にすると電圧が正確になる |
| `LCD_I2C_ADDR` | `0x27` | LCD バックパックの I2C アドレス（`0x3F` の基板もある） |
| `RESULT_HOLD_MS` | `15000` | 結果画面を出しておく時間 |
| `SPI_BUS_HZ` | `4000000` | MCP23S17 / SPI SRAM の SPI クロック |
| `SD_ALIVE_CHECK_MS` | `1500` | 待機中に SD カードの応答を確かめる間隔 |
| `CHUNK_BYTES` | `64` | `rd` の 1 行、`wr` の最大バイト数 |
| `BLOCK_BYTES` | `256` | SD との読み書きの単位 |
| `SD_TMP_NAME` | `"FSU_TMP.TMP"` | バックアップ中の一時ファイル |

## 5. 起動と周期処理

### 5.1 `setup()`

1. `Serial.begin(115200)`（PC の接続は待たない）。
2. /CS ピン（D4、D6、D7）を出力・High にしてから `SPI.begin()`、MCP23S17 の /RESET パルス（D5 を 1 ms Low）。
3. `ui_begin()`: `USE_LCD` が 1 なら I2C で LCD を探し、見つかれば初期化して自作文字を登録する。起動画面を出す。
4. `mcp_init()`: MCP23S17 を BANK=1・HAEN にして全チャネルを初期化し、`bus_idle()`。
5. `spi_sram_init()`（`USE_SPI_SRAM` のときだけ）: SPI SRAM（/CS = D6）があるかを確かめ、モードを電源投入時と同じシーケンシャル（`0x40`）に揃える。無くても止まらない（[hardware.md §9.1](hardware.md#91-spi-sramオプション本体だけでの処理の一時置き場)）。
6. `card_begin()`: D2 を内蔵プルアップの入力にしてカードの有無を読み、カードがあれば A2 で電池電圧を測る。
7. `sd_mount()`（`USE_SD` のときだけ）: SD カードがあればマウント。無くても止まらない。
8. 待機画面を出し、`FUJISOKU SRAM Utility 3.0 ready (LCD 20x4, SD off, SPI SRAM ok, card in). ...` を送る（LCD が無ければ `LCD none`、`USE_SD` が 1 なら `SD on`、SPI SRAM は `ok` / `none`（見つからない）/ `off`（使わない設定）、カードは `in` / `none` / `-`（検出しない設定））。

### 5.2 `loop()`

`delay()` は使わず、次の 4 つを繰り返します。

| 関数 | 内容 |
|---|---|
| `proto_poll()` | シリアルから 1 行ずつ取り込んでコマンドを実行。PC 主導の表示が 8 秒止まったら表示を戻す |
| `ui_poll()` | 待機画面のカード・電池・SD・PC 表示の更新（0.2 秒ごと）、結果画面から待機画面への切り替え、`lcd on` のときの画面送信 |
| `card_poll()` | カードの抜き差し（50 ms のチャタリング除去、`E CARD 1/0`）と電池電圧（0.5 秒ごと、50 mV 以上の変化か警告の境目で `E BATT <mV>`） |
| `sd_idle_check()` | （`USE_SD` のときだけ）SD が使える状態なら 1.5 秒ごとに応答を確かめ、抜かれたら `E SD 0` |

## 6. 処理（`operations.ino`）

### 6.1 対象メモリ

| 対象 | 定義 | コマンドの文字 | 読み書き |
|---|---|---|---|
| FUJISOKU カード | `DEV_FUJISOKU` | `f` | `read_fujisoku()` / `write_fujisoku()` |
| SPI SRAM | `DEV_SPI_SRAM` | `s` | `read_spi_sram_byte()` / `write_spi_sram_byte()`（/CS = D6。`USE_SPI_SRAM` で、見つかったときだけ） |

`dev_read()` / `dev_write()` / `dev_name()` が対象を振り分けます。使えない対象（使わない設定、SPI SRAM が見つからない、カードが入っていない）は、コマンドを受けたときに `protocol.ino` の `dev_ready()` が `ERR DISABLED` / `ERR NOSPI` / `ERR NOCARD` ではじきます。

### 6.2 処理の枠組み

本体だけで行う処理は、すべて同じ流れです。

| 段階 | 関数 | PC への出力 | 画面 |
|---|---|---|---|
| 開始 | `op_start()` | - | 進捗画面（題名、内容） |
| 段階 | `op_phase()` | `S <段階>` | 2 行目 |
| 進捗 | `op_step()` | `P <済み> <合計>`（0.1 秒ごと） | 進捗バーと %（変わるたび）、アドレスと速度（0.5 秒ごと） |
| 終了 | `op_finish()` | `OK` / `NG` / `ERR` の 1 行 | 結果画面 |

- `op_step()` のたびに PC からの入力を確かめ、`!` があれば中断します（`ERR CANCEL cancelled`）。
- `op_finish()` は最初に `bus_idle()` を呼び、アドレス・データ線を入力に戻して制御線をすべて非選択にします。
- 処理中に届いた `!` 以外の入力は読み捨てます。

### 6.3 処理の一覧

| 処理 | 関数 | 画面の題名 | 内容 |
|---|---|---|---|
| コピー | `op_copy(src, dst)` | WRITE CARD / READ CARD / COPY | 1 バイトずつ読んで書く（任意の 2 つの対象） |
| 比較 | `op_compare(a, b)` | COMPARE | 全域を比べ、最初の 8 か所を `M` 行で、不一致の数と最初のアドレスを終了行で返す |
| 消去 | `op_erase(dev)` | ERASE | すべて `FF` |
| SD に保存 | `op_sd_save(dev, name)` | BACKUP / SAVE | 256 バイトずつ一時ファイルに書き、閉じてから名前を付け替える（SD の処理は 4 つとも `USE_SD` のときだけ） |
| SD から書き込み | `op_sd_load(dev, name, v)` | RESTORE / LOAD | 32,768 バイトちょうどのファイルだけ。`v` 付きなら続けて照合（進捗の合計は 65,536） |
| SD と照合 | `op_sd_verify(dev, name)` | VERIFY | 256 バイトずつ比べる |
| SD の一覧 | `op_sd_list()` | SD FILES | ルートの `*.bin` を最大 32 件 |
| SD の確認 | `op_sd_check()` | SD CHECK | マウントし直す |
| SPI SRAM の自己診断 | `op_test_spi()` | SPI SRAM TEST | `USE_SPI_SRAM` のときだけ。SPI SRAM を探し直してモードレジスタを読み（`T mode=40`。`FF` なら応答なし）、0x0000〜 と 0x7FF0〜 の 16 バイトに 2 種類の値を書いて読み戻す（元の値は戻す）。違いが 0 なら OK |

v1 との違い:
- `R` / `C` は書き込み前の消去をやめました（全域を上書きするため不要）。
- SD から書き込むとき、ファイルの大きさを確かめます（32,768 バイトでなければ書かない）。
- v1 の毎秒のメニュー表示、TFT の描画、使われていなかったコードは削除しました。

### 6.4 カードの抜き差しと電池電圧（`card.ino`）

| 項目 | 内容 |
|---|---|
| カードの有無 | D2（/CARD DET、内蔵プルアップ）。`CARD_DET_ACTIVE_LOW` が 1 なら Low = カードあり。50 ms 同じ値が続いたら `card_inserted` を変え、`E CARD 1` / `E CARD 0` を送る |
| カードが無いとき | `dev_ready()` が、カードを使うコマンドに `ERR NOCARD No card in the slot` を返す（`rd f` `wr f` `fill f` `copy` `cmp` `erase f` `sd save/load/verify f`、`R` `C` `X` `B` `L` `V` `e`） |
| 処理中に抜かれたら | カードを使うコマンドでは `op_needs_card` を立てる。`op_poll_cancel()` が 3 回続けて「無い」と読んだら中断し、`ERR NOCARD Card removed at 0x....`（PC 主導の `rd` / `wr` / `fill` は `ERR NOCARD Card removed`）。バスは待機状態に戻す |
| 電池電圧 | A2（BATT-DET）。12 ビットで 8 回測って平均し、`BATT_ADC_FULL_MV`（5000 mV）を満点として mV にする。0.5 秒ごと。カードが無いときは測らない（`batt_mv` = -1）。挿してから 0.1 秒後に測り直す |
| 知らせ方 | 前に送った値から 50 mV 以上変わったとき、または警告の境目（「少ない」「電池なし」）をまたいだときに `E BATT <mV>`。`status` の `batt=` はいつでも最新の値 |
| 電池なし | `batt_mv` が `BATT_NONE_MV`（500 mV）以下（`batt_none()`）。A2 と GND の間の 1 MΩ で、電池が無いと 0 V 近くになる（無いと漏れ電流で 3〜4 V に浮く）。LCD は `Bat:NONE!`、4 行目に `! No card battery`。Web アプリは「なし」と画面の上の警告 |
| 少ない | `batt_mv` が `BATT_LOW_MV`（1700 mV）以下（`batt_low()`。電池なしも含む）。LCD は電圧の後ろに `!`、4 行目に `! Card battery low`。Web アプリは画面の上に警告を出す |
| 電池の種類との関係 | `batt_mv` は A2 の測定値そのままで、電池の種類による補正はしない。テスターで測った電池電圧は、CR2016 が A2 の測定値の約 1.20 倍、BR2325 が約 1.14 倍。1.70 V 以下はテスターの値で約 2 V（CR2016 約 2.05 V、BR2325 約 1.94 V）にあたる（実測は [hardware.md](hardware.md) §6.1） |

## 7. SD カードの扱い（`storage.ino`、オプション）

この章は `USE_SD` が 1 のときの動作です。0 のときは §3.2 のとおり SD のコードがなく、`sd_state` は `SD_STATE_UNKNOWN` のままです。

| 状態 | 意味 |
|---|---|
| `SD_STATE_UNKNOWN` | 起動直後 |
| `SD_STATE_READY` | マウント済み |
| `SD_STATE_ABSENT` | 無い、または抜かれた |

- **SD を使う処理を始めるたびに `sd_mount()` でマウントし直します。** 処理の合間に抜き差し（差し替えを含む）しても、次の処理は新しいカードで動きます。
- 処理の途中で読み書きに失敗したら、カードが応答するか（`sectorCount()` が 0 でないか）を確かめ、応答すれば `SDERR`、しなければ `SDLOST` として終わります（`SDLOST` のときは状態を ABSENT にして `E SD 0`）。
- 待機中は READY のときだけ 1.5 秒ごとに応答を確かめます。ABSENT のときは確かめません（カードが無いと `SD.begin()` が約 2 秒止まるため）。挿したカードは、次の SD 処理か `sdcheck` で認識します。
- `SD.end()` は UNO R4 では共有の SPI ごと止めるので、直後に `spi_revive()` で動かし直します。
- 状態が変わると `E SD 0` / `E SD 1` を PC に送り、画面の表示も変わります。

## 8. 表示（LCD と Web アプリ）

LCD の表示

どの画面でも、4 行目の右下（20 文字目）に署名の © が出ます（自作文字）。4 行目に書く文字は 19 文字までです。

上の図は左上から、待機、処理中（SD に保存）、完了、不一致、SD カードなし、PC 主導の処理中です。

| 画面 | 1 行目 | 2 行目 | 3 行目 | 4 行目 |
|---|---|---|---|---|
| 待機 | `FUJISOKU SRAM v2.8` | `Card:OK / NONE` と電池電圧（例 `Bat:2.75V`。1.70 V 以下は後ろに `!`、0.50 V 以下は `Bat:NONE!`） | `SD:OK / NONE / off`、`PC:OK / --` | `Last:` 直前の結果。電池が 1.70 V 以下なら `! Card battery low`、0.50 V 以下なら `! No card battery`。右下に © |
| 処理中 | 題名と経過時間 | 段階 | 進捗バー（15 文字）と % | アドレス / 合計と速度（例 `0x3B00/8000  3.2k/s`）、右下に © |
| 結果 | 記号、題名、見出し（`DONE` `MISMATCH` `NO SD` `SD LOST` `CANCELED` など） | 説明（2 行に折り返し） | | 所要時間とエラーコード（例 `Time 00:02 NOSD`）、右下に © |

- 画面の内容は `lcd_shadow[4][20]` にいつも持っています。`lcd_row()` は前回の内容と比べて変わった文字だけを記録し、LCD があればその文字だけを送ります（I2C の LCD は 1 文字約 1 ms かかるため。32KB の保存全体で LCD に送るのは数百文字）。
- LCD の有無: `USE_LCD` が 1 なら、`ui_begin()` で `LCD_I2C_ADDR` に I2C で呼びかけ、応答がなければ `lcd_present` を false にして、以後 LCD には何も送りません。`USE_LCD` が 0 なら LCD のコードはありません。どちらの場合も `lcd_shadow` は更新され、`lcd` コマンドや Web アプリへの送信は同じように動きます。
- 進捗バーは CGRAM に登録した自作文字で、1 文字を 5 段階に分けます（15 文字 = 75 段階）。空き部分は文字 ROM の `_` です。チェック・バツの記号と署名の © も自作文字です（CGRAM 0〜4 = バー、5 = ©、6 = チェック、7 = バツ）。自作文字は文字コード `0x08`〜`0x0F` で書きます（`0x00`〜`0x07` と同じ文字で、文字列に 0 を入れずに済む）。
- 結果画面は 15 秒で待機画面に戻ります。次の処理が始まれば、すぐ進捗画面になります。
- 文字は ASCII だけを使います（LCD の文字 ROM の違いに左右されないように）。
- `lcd on` のあいだ、表示が変わるたび（最短 0.25 秒間隔）に `LCD <16進 160 桁>` を PC に送ります。Web アプリはこれで本体と同じ画面を描きます。

## 9. PC との通信（`protocol.ino`）

コマンドと応答の書式は [protocol.md](protocol.md) にまとめています。

- 受信した文字を 1 行（最大 199 文字）にためて、改行で実行します。長すぎる行は `ERR LINE` を返して捨てます。
- 1 文字だけの行は v1 の 1 文字コマンドとして扱います。
- `rd` `wr` `fill` のアドレスと長さは `range_ok()` で、対象ごとの大きさ（`dev_size()`: カード `CARD_MAX_SIZE` = 1MB、SPI SRAM 64KB）に収まるかを確かめます。`アドレス + 長さ` の桁あふれ（例: `rd f 0xFFFFFFF0 0x20`）も範囲外として `ERR RANGE` にします（v2.2 までは桁あふれで確認をすり抜け、A16/A17 が立った番地を読めてしまいました）。
- `!` は行に入れず、待機中なら捨てます（処理中は `op_poll_cancel()` が中断の合図として受け取る）。
- `USE_SD` が 0 のとき、SD のコマンドは `ERR DISABLED SD card is not used (USE_SD 0)` を返します。
- PC 主導の表示（`ui begin` 〜 `ui end`）の間は `op_session = 2` で、本体だけの処理は `ERR BUSY` になります。どのコマンドが届いても連絡があったものとして時刻を更新し、8 秒届かなければ画面に「PC LOST」を出して `E UI timeout` を送ります。

## 10. ファイル形式

| 項目 | 内容 |
|---|---|
| 中身 | カードの 0x0000 からをそのまま並べたもの（ヘッダなし） |
| 大きさ | 32,768 バイト。Web アプリでは 32KB〜1MB（SD は 32,768 バイトだけ） |
| SD 上の名前 | 英数字と `_` `-` の 16 文字まで + `.bin`（既定 `fujisoku.bin`） |
| PC 上の名前 | Web アプリの既定は `fujisoku_日付_時刻.bin`、書き込み前の自動保存は `backup_日付_時刻.bin`（32KB 以外は `_64KB` のように大きさが付く） |

## 11. データを守るための仕組み

| 場面 | 仕組み |
|---|---|
| SD への保存が途中で止まった（SD あり） | 一時ファイルに書き、最後に名前を付け替える。前のファイルは残る |
| サイズの違うファイル | 本体（`sd load`）は 32,768 バイトでなければ書き込まない。Web アプリは 32KB〜1MB のファイルだけを受け付ける |
| 32KB より大きいファイル | Web アプリは「書き込む大きさ」のボタン（32KB〜1MB、既定はファイルの大きさ）で書く範囲を選び、32KB より大きく書くときは警告して「先頭 32KB だけ」か「すべて」かを選ばせる（32KB のカードに 32KB を超えて書くと先頭が上書きされるため）。読み込みは既定 32KB |
| 上書きの前 | Web アプリは確認ダイアログを出し、既定で書き込む前のカードを PC に保存する |
| 読み違い | Web アプリは既定で 2 回読んで比べ、違えば保存しない |
| 書き込みの確かめ | `sd load ... v` と Web アプリの書き込みは、読み戻して照合する |
| PC が途中で止まった | 本体は 8 秒で PC 主導の表示を終える。カードへの書き込みは 64 バイト単位なので、途中までは書かれている（Web アプリの自動保存から戻せる） |
| カードの挿し忘れ | /CARD DET で検出し、カードが無ければカードを使う操作を止める（空の `FF` を「保存できた」と思い込まない）。処理中に抜かれても止める |
| 電池切れ・電池なし | 電池電圧を表示し、1.70 V 以下で「少ない」、0.50 V 以下で「電池なし」と警告。中身が消える前に保存できる |
| 配線の不安 | SPI SRAM は `test` で確かめられる（見つからないときも実行できる） |
| 範囲外のアドレス | PC からの `rd` `wr` `fill` は、桁あふれも含めて対象の範囲（カード 1MB、SPI SRAM 64KB）の外を断る |

## 12. 変更履歴

### 12.1 v3.0（62256 をやめ、A18・A19 を駆動。ブランチ `wo62256`）

| 区分 | 内容 |
|---|---|
| ハードウェア | ch7 ポート B の割り当てを変えた: B0 CE2、B1 /OE、**B2 /CE1**（v2.8 は B4）、B3 /WE、**B4〜B7 A16〜A19**（v2.8 は B6・B7 が A16・A17、A18・A19 は GND に固定）。v2.8 の基板は ch7 の GPB2・GPB4〜GPB7 の配線をつなぎ直す必要がある（[hardware.md §7](hardware.md#7-ch7-ポート-b制御線と-a16a19)） |
| 制御値 | 待機 `0x0F`、カード選択 `0x0B`、カード解放 `0x0E`。A16〜A19 は `(address >> 12) & 0xF0`。`static_assert` で確かめる |
| 62256 | `USE_SRAM62256`、対象 `p`、`test p` を削除。`p` は `ERR ARG`。`hello` から `sram62256=` を外した。起動メッセージから `62256 on/off` を外した |
| 範囲 | PC からのカードの `rd` `wr` `fill` を 1MB（0x00000〜0xFFFFF）にした。`hello` は `cardmax=1048576` |
| Web アプリ | 読み込む大きさに 512KB と 1MB を足した。書き込みに「書き込む大きさ」のボタン（32KB / 64KB / 128KB / 256KB / 512KB / 1MB、既定はファイルの大きさ。それ以外の大きさのファイルは「全体」）を足した。32KB より大きく書くときの「先頭 32KB だけ / すべて」のダイアログは残し、「すべて」は選んだ大きさを書く。32KB〜1MB のファイルを書き込める。62256 の表示と操作を外した |
| KiCad | 回路図とシールド基板を新しい割り当てにし、62256（U4）を外した。シールドは配線をやり直した（DRC エラー 0） |
| テスト | シミュレータを新しい割り当てと 1MB のカードに合わせた。62256 の構成をやめ、A16〜A19 のテストと、Web アプリで 1MB のカードを 256KB / 512KB / 1MB で読み書き・照合するテストを足した（66 件すべて成功） |
| 実機 | **まだ確かめていない** |

### 12.2 v2.8（電池の判定電圧。リリース版）

| 区分 | 内容 |
|---|---|
| 判定電圧 | No battery を 0.40 V → **0.50 V**（`BATT_NONE_MV` = 500）、Low battery を 2.00 V → **1.50 V** にしたあと、電池の実測（[hardware.md](hardware.md) §6.1）に合わせて **1.70 V**（`BATT_LOW_MV` = 1700）にした。1.70 V はテスターの値で約 2 V（CR2016 約 2.05 V、BR2325 約 1.94 V）にあたる |
| config.h | 2 つの判定電圧を `config.h` の先頭（`USE_BATT_DET` のすぐ下）に移し、どの電圧でどう判定するかを書いた。`BATT_NONE_MV` < `BATT_LOW_MV` でなければビルドが止まる（`static_assert`） |
| 通信 | `hello` は `battlow=1700 battnone=500` |
| 実機 | Arduino UNO R4 と作者の基板で動作を確認済み（Low battery を 1.50 V → 1.70 V にした変更は、まだ実機で確かめていない） |
| 公開 | v2.8 をリリース版にした（2026-11-08） |

### 12.3 v2.7（電池なしの検出）

| 区分 | 内容 |
|---|---|
| 配線 | A2 と GND の間に 1 MΩ を足す。電池が無いと BATT-DET が浮いて 3〜4 V に見えていた（実機で 3.6 V）。1 MΩ 付きの実測は、電池なし 0.24 V、新品の電池 2.75 V |
| 電池なし | `BATT_NONE_MV`（既定 400 mV）以下を「電池なし」とする（`batt_none()`）。LCD は `Bat:NONE!` と `! No card battery`、Web アプリは「なし」と警告 |
| Low battery | `BATT_LOW_MV` を 1000 mV から 2000 mV に上げた（新品の電池が 2.75 V と表示されるため。2.00 V 以下で「少ない」） |
| LCD の署名 | どの画面でも 4 行目の右下（20 文字目）に自作文字の © を出す。4 行目の文字は 19 文字までにした（進捗の `0x3B00/8000  3.2k/s`、結果の `Time 00:02 NOSD` など）。進捗バーの空き部分は文字 ROM の `_` にして、空いた自作文字を © に使った |
| 進捗の表示 | 書き込み + 照合（や 2 回の読み込み）を足したバイト数を合計として出していたため、32KB の書き込みが 64KB、64KB が 128KB に見えていた（実際に書くのはファイルの大きさだけ）。Web アプリのバイト数と LCD の進捗を段階ごとにした（`ui begin` を段階ごとに送り直す） |
| 実機 | Arduino UNO R4 と作者の基板で動作を確認済み（電池なし・Low battery の判定、LCD の署名、進捗の表示を含む） |
| 通信 | `hello` に `battnone` を追加。境目（0.40 V）をまたいだら `E BATT` を送る |

### 12.4 v2.6（カードの検出と電池電圧）

| 区分 | 内容 |
|---|---|
| 配線 | カードの /CARD DET（F37）を D2、BATT-DET（F2）を A2 に直接つなぐ |
| カードの検出 | `USE_CARD_DET`（既定 1）。カードが無いとカードを使う操作は `ERR NOCARD`。処理中に抜かれたら止めて `ERR NOCARD Card removed at 0x....`。抜き差しは `E CARD 1/0` |
| 電池電圧 | `USE_BATT_DET`（既定 1）。0.5 秒ごとに測り、`E BATT <mV>` で知らせる。1.00 V（`BATT_LOW_MV`）以下で LCD と Web アプリに警告 |
| 通信 | `hello` に `carddet` `battdet` `battlow`、`status` に `card` `batt` を追加 |
| 表示 | LCD の待機画面の 2 行目をカードと電池に、3 行目を SD・PC にした。Web アプリの「本体」欄にカードと電池、電池が少ないときは画面の上に警告 |
| Web アプリのファイル欄 | 選んだファイルを × で外せるようにした。同じ名前のファイルも選び直せる |
| 実機 | Arduino UNO R4 と作者の基板で動作を確認済み（D2 のカード検出、A2 の電池電圧を含む） |

### 12.5 v2.5（SPI SRAM をオプションに。リリース版）

| 区分 | 内容 |
|---|---|
| オプション | `USE_SPI_SRAM`（既定 1）を追加。1 のときは起動時に SPI SRAM を探し、見つからなければ SPI SRAM を使う操作は `ERR NOSPI`。0 なら SPI SRAM のコードを入れず `ERR DISABLED` |
| 検出 | `spi_sram_init()` がモードレジスタにバイト → シーケンシャルと書いて読み戻し、2 つとも合えば「あり」。自己診断（`test`）は見つからなくても実行し、探し直す |
| 通信 | `hello` に `spisram=ok|none|off`、起動メッセージに `SPI SRAM ok|none|off`。`status` の `spi=` は使わない設定で `-` |
| エラー | `ERR NOSPI` を追加。使わない設定の 62256（`p`）も `ERR ARG` から `ERR DISABLED` に変えた |
| Web アプリ | 本体の欄に SPI SRAM の状態を表示。使わない設定なら SPI SRAM の操作を隠し、見つからなければ自己診断だけ出す。カードの消去はいつでも使える |
| 実機 | Arduino UNO R4 と作者の基板で動作を確認済み（SPI SRAM のオプション化を含む） |
| 公開 | v2.5 をベータ版からリリース版にした（2026-11-07） |

### 12.6 v2.4（32KB より大きいカード）

| 区分 | 内容 |
|---|---|
| 範囲 | PC からの `rd` `wr` `fill` を対象ごとの大きさにした（カード 0x00000〜0x3FFFF = 256KB、SPI SRAM 64KB、62256 32KB）。本体だけの処理は 32KB のまま |
| 通信 | `hello` に `cardmax=262144` を追加。`D` 行のアドレスは 0x10000 以上で 5 桁 |
| Web アプリ | 読み込む大きさを 32KB（既定）/ 64KB / 128KB / 256KB のボタンで選ぶ。32KB〜256KB のファイルを書き込める。32KB より大きいときは「先頭 32KB だけ」か「すべて」かを警告で選ぶ。比較とメモリマップ・16 進表示も大きさに合わせる |
| 上限 | 256KB（A0〜A17）。A18・A19 は MCP につながっていない |

### 12.7 v2.3（コードレビューの結果）

| 区分 | 内容 |
|---|---|
| 配線 | SPI SRAM の /CS は D6 だけ。MCP23S17 ch7 B5 経由の /CS の読み書き・自己診断・起動時の設定を削除し、B5 は未使用にした |
| 不具合 | `rd` `wr` `fill` の範囲確認が `アドレス + 長さ` の桁あふれですり抜けていたのを修正（§9） |
| 不具合 | `config.h` の SPI SRAM のモード定数（ページとシーケンシャル）が逆だったのを修正 |
| 書き込みの順 | 「/WE = L → データ → /WE = H」を「データ → /WE = L → /WE = H」に変更。/WE が Low のあいだに前の値が一瞬書かれることがなくなった（[hardware.md §8](hardware.md#8-アクセスシーケンス)） |
| 速さ | 直前に書いた制御値の読み戻し（OLAT_B）をやめ、バスの向きは変わるときだけ設定する。1 バイトの MCP23S17 へのアクセスが 11〜12 回から 7 回になった |
| 読みやすさ | 制御線をビットごとの名前（`CTRL_*`）にして、状態の値をそこから組み立てた（値は v1 と同じで、`static_assert` で確認）。ピン（`PIN_*`）・MCP23S17（`MCP_*`）・SPI SRAM（`SRAM23_*`）の名前をそろえ、使っていない定数を削除。カードと 62256 の読み書きを共通の関数（`bus_read_byte()` / `bus_write_byte()`）にまとめた |
| 既定の構成 | `USE_SD` の既定を 0（SD カードなし）に変更。カードの保存は Web アプリで PC にできるため。SD を使うときは 1 にして SdFat を入れる |
| 整理 | 使われていなかった `sd_changed`、`ui_progress_begin()` の引数 `from_pc` を削除。TFT・タッチ時代のコメントを直した |
| 62256 の試験 | アドレス線の試験の説明（H 固定・L 固定）が実際の判定と合っていなかったので直した（判定そのものは同じ） |

## 13. 確かめたこと

実機（Arduino UNO R4 と作者の基板）での動作を v2.8 まで確認済みです。**v3.0（ブランチ `wo62256`）の新しい ch7 ポート B の割り当ては、まだ実機で確かめていません。**あわせて、次の自動確認を行っています（手順は [test/README.md](../test/README.md)）。

| 確認 | 内容 |
|---|---|
| ホストでのビルド | スケッチを Arduino IDE と同じ手順で 1 ファイルにまとめ、既定（SD なし）・SD あり・SD あり + `USE_LCD=0`・`USE_SPI_SRAM=0`（カード検出・電池も 0）の 4 通りを `-Wall -Wextra` で警告なしにビルド |
| 本物のライブラリでの型チェック | 本物の SdFat と LiquidCrystal I2C のヘッダに対して、4 通り（既定、SD・LCD あり、SD あり・LCD なし、最小構成（SD・LCD・SPI SRAM・カード検出・電池なし））すべて警告・エラーなし。使わない部品のライブラリは渡さずに確認（既定は SdFat なし、SD・LCD なしは外部ライブラリなし） |
| シミュレータでの動作 | MCP23S17 ×2（BANK・HAEN・A2 の癖まで）、カード（32KB〜1MB）、23LC512、SD カード（抜き差し・差し替え）、HD44780 LCD（あり・なし）を再現したシミュレータで、ファームウェア 30 件、表示 9 件、Web アプリ 27 件の自動テストがすべて成功 |
| バスの使い方 | ファームウェアと表示のテストで、トランザクション外の SPI 転送、MCP の上限を超えるクロック、バス衝突、書き込み中のアドレス・データの変化、2 つ以上の /CS が同時に Low、LCD の CGRAM への誤書き込み、LCD が無いのに LCD へ送ること、が 0 件。`USE_SD=0` では SD カードへのアクセスが 0 件 |
| A16〜A19 | 1MB のカードで 0x10000 / 0x20000 / 0x40000 / 0x80000 / 0xC0000 / 0xFFFFF が別の場所になり、256KB のカードでは 0x40000 が先頭と重なることを確認。読み書きのあと ch7 GPB は待機値 `0x0F` |

## 14. 注意点

- `USE_LCD` が 1 で LCD が無い場合、起動時の検出に最大 0.1 秒かかるだけで、ほかの動作には影響しません。LCD があるのに表示されないときは、`LCD_I2C_ADDR` を `0x3F` にするか、バックパックの半固定抵抗でコントラストを調整してください。
- 処理の速さは実機で測っていません。シミュレータの見積もりでは、32KB の読み込みが 7 秒前後です（v2.2 は 10 秒前後。[hardware.md §8](hardware.md#8-アクセスシーケンス)）。
- SPI SRAM の /CS は D6 です（MCP23S17 にはつながない）。
- Web アプリは Web Serial を使うため、PC の Chrome / Edge が必要です（スマートフォンは不可）。
