cheeky-smokey/FUJISOKU-SRAM-Utility/hardware/kicad/FUJISOKU_SRAM_Utility.pdf

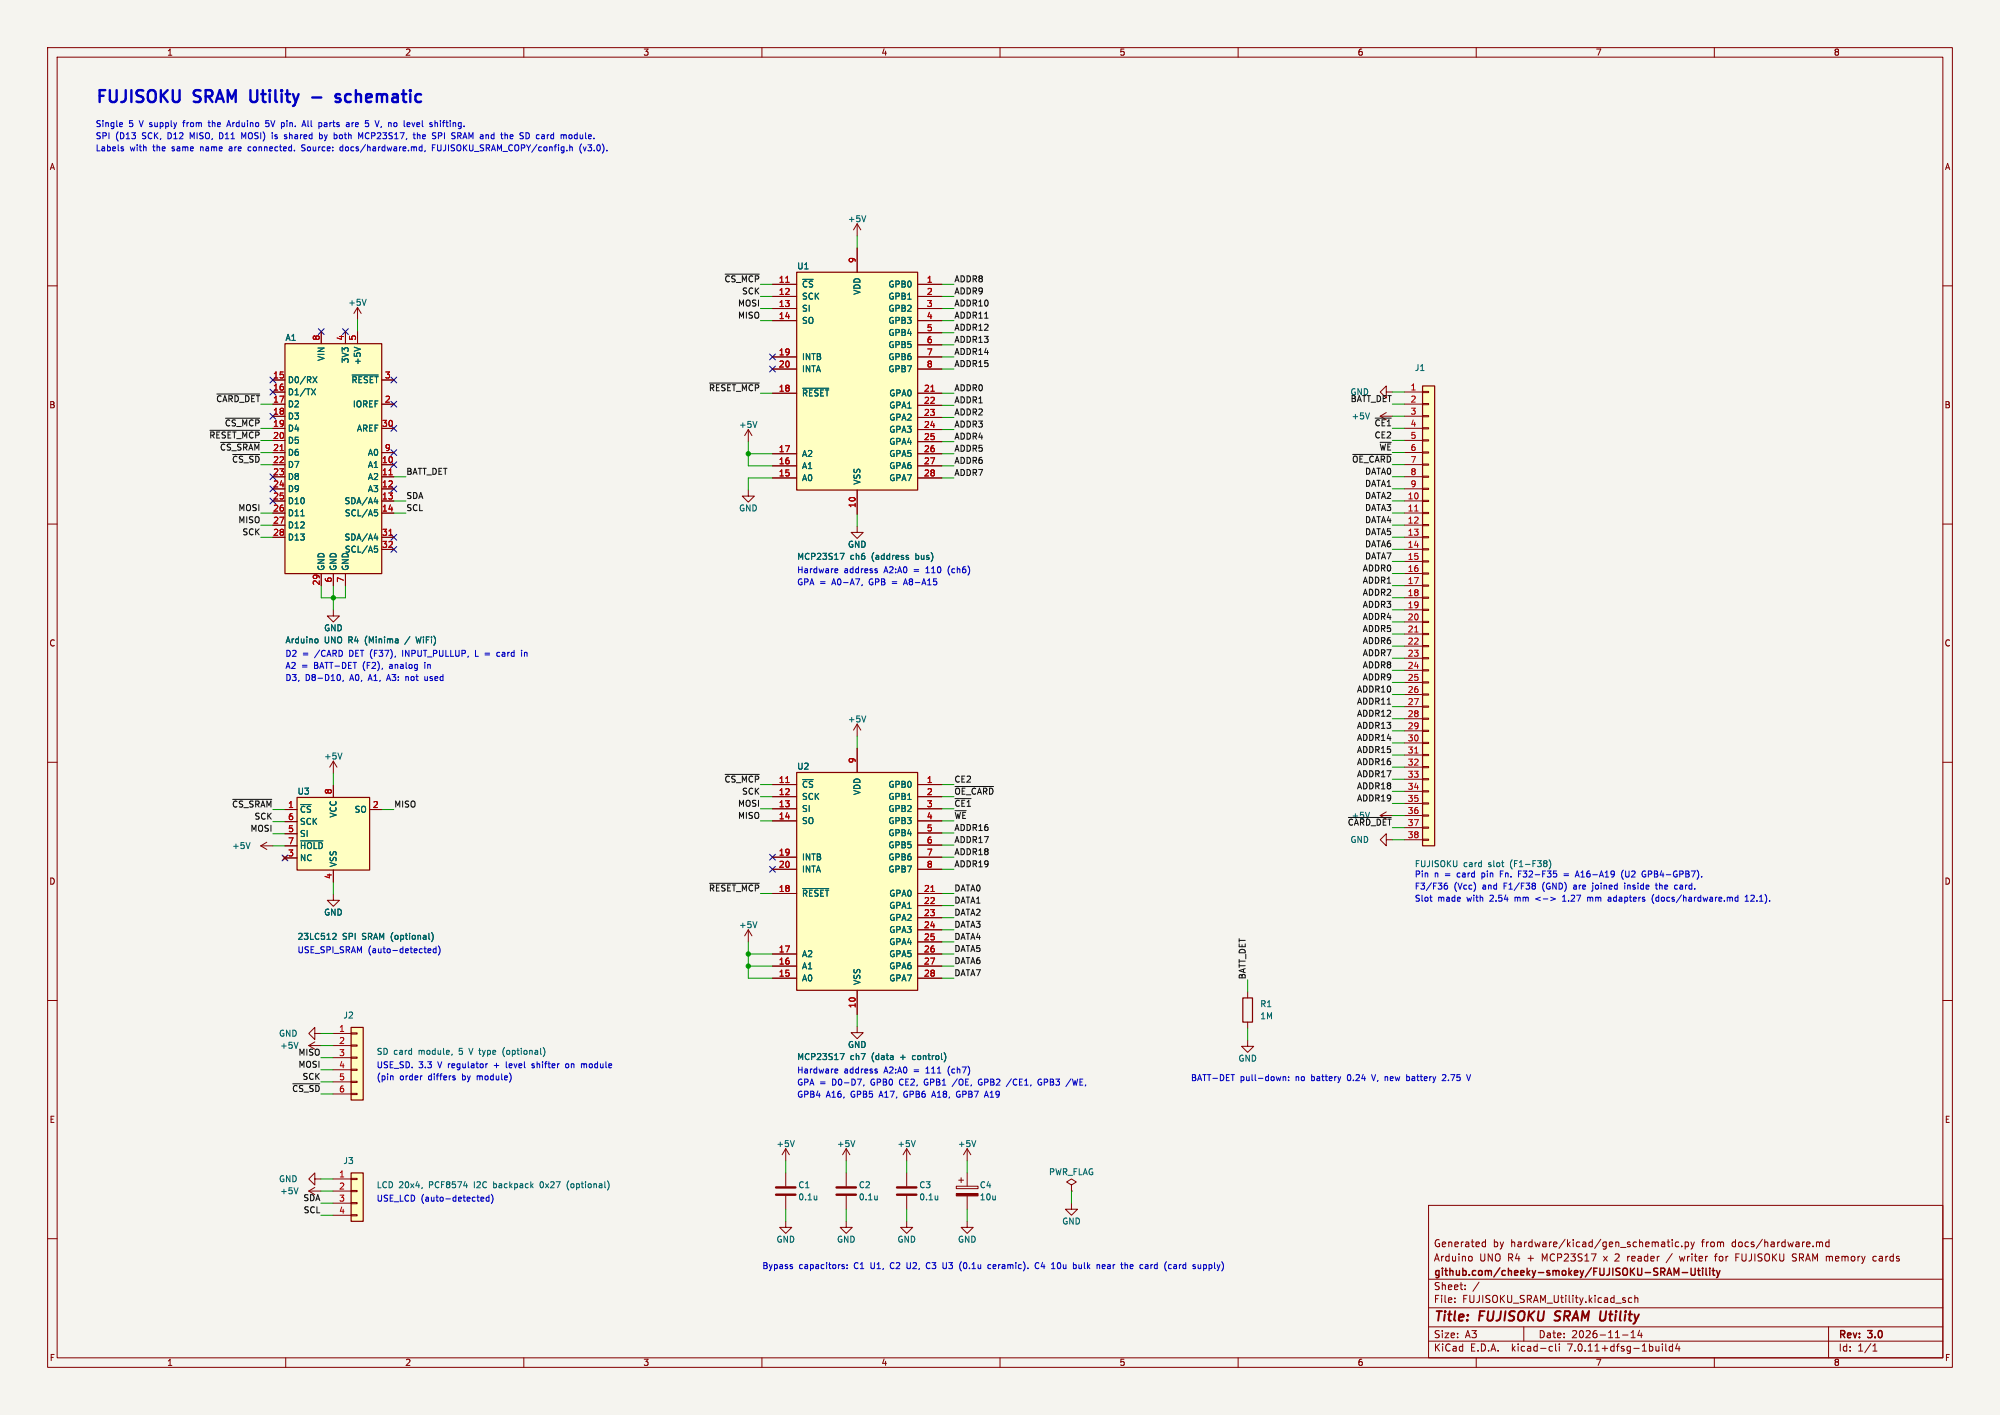
[picture p10: page 1]

FUJISOKU SRAM Utility - schematic

9 U1 MCP23S17 ch6 (address bus) GND GND

8 A0 9 A1Arduino UNO R4 (Minima / WiFi) GND

D2 = /CARD DET (F37), INPUT_PULLUP, L = card in

4 SI 5 SCK 6 ~{HOLD} 7 VCC

Id: 1/1 Title: FUJISOKU SRAM Utility
