cheeky-smokey/FUJISOKU-SRAM-Utility/hardware/kicad/shield/FSU_Shield_1to1.pdf

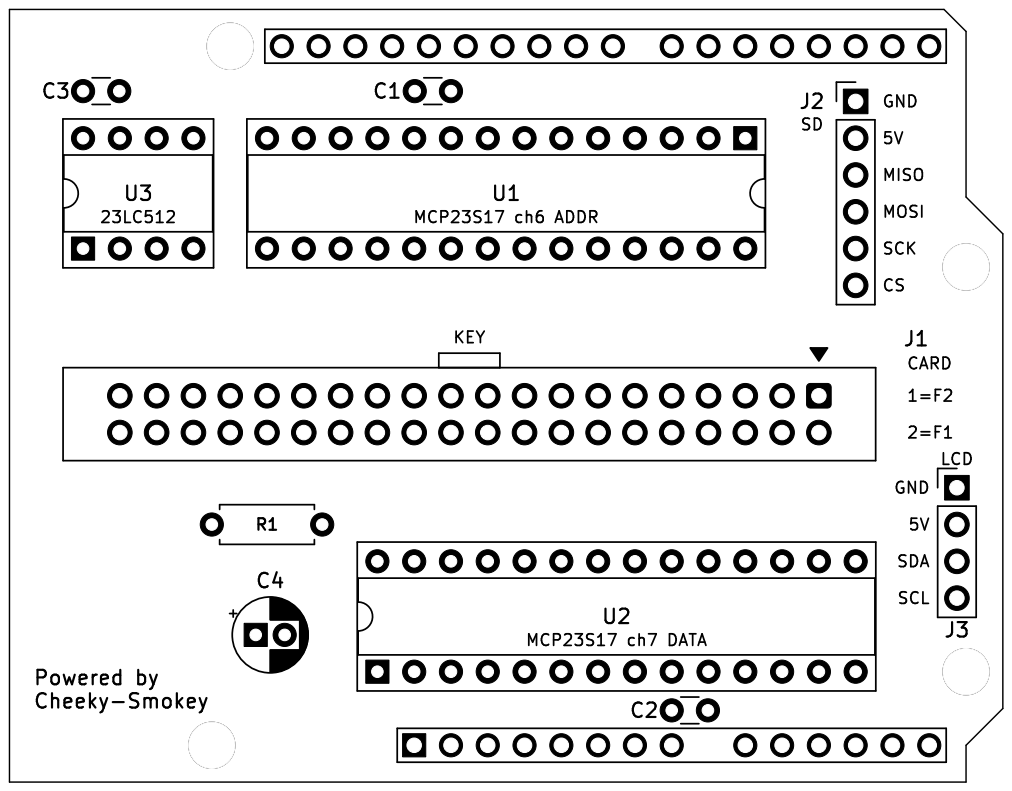
[picture p11: page 1]

5V Powered by Cheeky-Smokey
