cheeky-smokey/FUJISOKU-SRAM-Utility/hardware/kicad/shield/FSU_Shield.kicad_pcb

## KiCad design hardware/kicad/shield/FSU_Shield.kicad_pcb (2026-11-14)

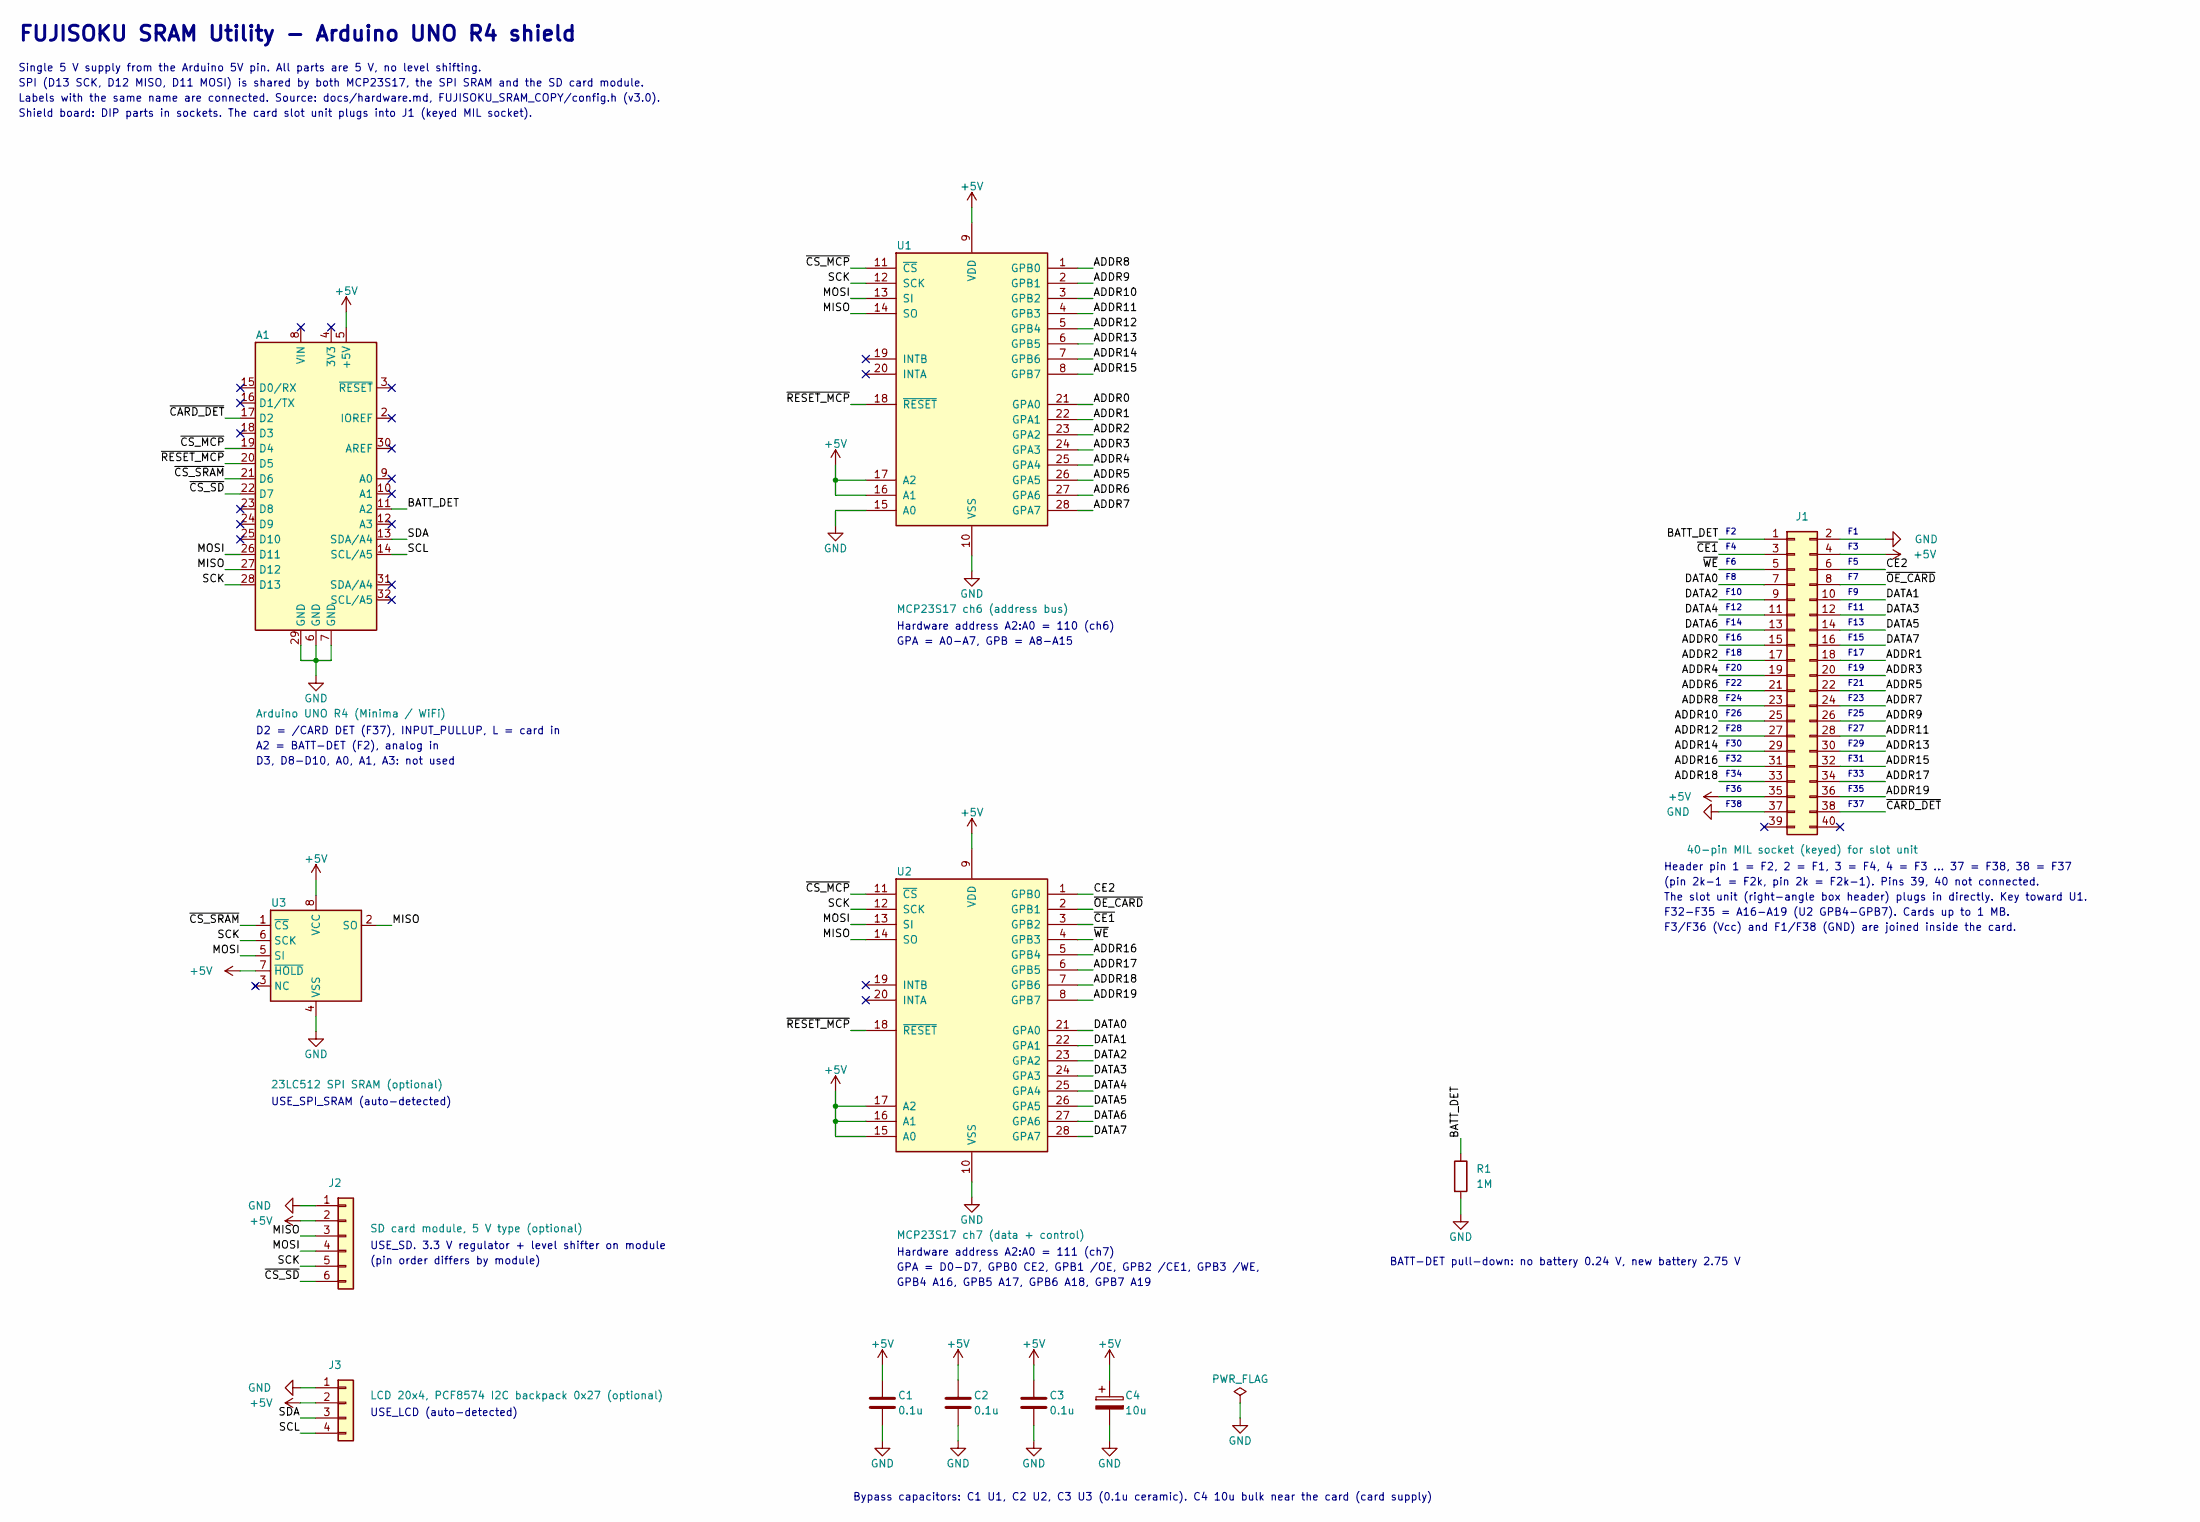
[picture p12: schematic FSU_Shield.kicad_sch, FUJISOKU SRAM Utility - UNO R4 shield]

Parts:
A1: Arduino UNO R4 (Minima / WiFi); Arduino_UNO_R4_Shield
C1, C2, C3: 0.1u; C_Disc_D3.0mm_W1.6mm_P2.50mm
C4: 10u; CP_Radial_D5.0mm_P2.00mm
J1: 40-pin MIL socket (keyed) for slot unit; MIL_Socket_2x20_P2.54mm_Vertical
J2: SD card module, 5 V type (optional); PinHeader_1x06_P2.54mm_Vertical
J3: LCD 20x4, PCF8574 I2C backpack 0x27 (optional); PinHeader_1x04_P2.54mm_Vertical
R1: 1M; R_Axial_DIN0207_L6.3mm_D2.5mm_P7.62mm_Horizontal
U1: MCP23S17 ch6 (address bus); DIP-28_W7.62mm_Socket
U2: MCP23S17 ch7 (data + control); DIP-28_W7.62mm_Socket
U3: 23LC512 SPI SRAM (optional); DIP-8_W7.62mm_Socket

Connections:
+5V: A1.5 (+5V), C1.1, C2.1, C3.1, C4.1, J1.4, J1.35, J2.2, J3.2, U1.9 (VDD), U1.16 (A1), U1.17 (A2), U2.9 (VDD), U2.15 (A0), U2.16 (A1), U2.17 (A2), U3.7 (~HOLD), U3.8 (VCC)
/ADDR0: J1.15, U1.21 (GPA0)
/ADDR1: J1.18, U1.22 (GPA1)
/ADDR2: J1.17, U1.23 (GPA2)
/ADDR3: J1.20, U1.24 (GPA3)
/ADDR4: J1.19, U1.25 (GPA4)
/ADDR5: J1.22, U1.26 (GPA5)
/ADDR6: J1.21, U1.27 (GPA6)
/ADDR7: J1.24, U1.28 (GPA7)
/ADDR8: J1.23, U1.1 (GPB0)
/ADDR9: J1.26, U1.2 (GPB1)
/ADDR10: J1.25, U1.3 (GPB2)
/ADDR11: J1.28, U1.4 (GPB3)
/ADDR12: J1.27, U1.5 (GPB4)
/ADDR13: J1.30, U1.6 (GPB5)
/ADDR14: J1.29, U1.7 (GPB6)
/ADDR15: J1.32, U1.8 (GPB7)
/ADDR16: J1.31, U2.5 (GPB4)
/ADDR17: J1.34, U2.6 (GPB5)
/ADDR18: J1.33, U2.7 (GPB6)
/ADDR19: J1.36, U2.8 (GPB7)
/BATT_DET: A1.11 (A2), J1.1, R1.1
/CE2: J1.6, U2.1 (GPB0)
/DATA0: J1.7, U2.21 (GPA0)
/DATA1: J1.10, U2.22 (GPA1)
/DATA2: J1.9, U2.23 (GPA2)
/DATA3: J1.12, U2.24 (GPA3)
/DATA4: J1.11, U2.25 (GPA4)
/DATA5: J1.14, U2.26 (GPA5)
/DATA6: J1.13, U2.27 (GPA6)
/DATA7: J1.16, U2.28 (GPA7)
/MISO: A1.27 (D12), J2.3, U1.14 (SO), U2.14 (SO), U3.2 (SO)
/MOSI: A1.26 (D11), J2.4, U1.13 (SI), U2.13 (SI), U3.5 (SI)
/SCK: A1.28 (D13), J2.5, U1.12 (SCK), U2.12 (SCK), U3.6 (SCK)
/SCL: A1.14 (SCL/A5), J3.4
/SDA: A1.13 (SDA/A4), J3.3
/~CARD_DET: A1.17 (D2), J1.38
/~CE1: J1.3, U2.3 (GPB2)
/~CS_MCP: A1.19 (D4), U1.11 (~CS), U2.11 (~CS)
/~CS_SD: A1.22 (D7), J2.6
/~CS_SRAM: A1.21 (D6), U3.1 (~CS)
/~OE_CARD: J1.8, U2.2 (GPB1)
/~RESET_MCP: A1.20 (D5), U1.18 (~RESET), U2.18 (~RESET)
/~WE: J1.5, U2.4 (GPB3)
GND: A1.6 (GND), A1.7 (GND), A1.29 (GND), C1.2, C2.2, C3.2, C4.2, J1.2, J1.37, J2.1, J3.1, R1.2, U1.10 (VSS), U1.15 (A0), U2.10 (VSS), U3.4 (VSS)

Notes on the sheet:
D2 = /CARD DET (F37), INPUT_PULLUP, L = card in
A2 = BATT-DET (F2), analog in
D3, D8-D10, A0, A1, A3: not used
Hardware address A2:A0 = 110 (ch6)
GPA = A0-A7, GPB = A8-A15
Hardware address A2:A0 = 111 (ch7)
GPA = D0-D7, GPB0 CE2, GPB1 /OE, GPB2 /CE1, GPB3 /WE,
GPB4 A16, GPB5 A17, GPB6 A18, GPB7 A19
F10
F12
F11
F14
F13
F16
F15
F18
F17
F20
F19
F22
F21
F24
F23
F26
F25
F28
F27
F30
F29
F32
F31
F34
F33
F36
F35
F38
F37
Header pin 1 = F2, 2 = F1, 3 = F4, 4 = F3 ... 37 = F38, 38 = F37
(pin 2k-1 = F2k, pin 2k = F2k-1). Pins 39, 40 not connected.
The slot unit (right-angle box header) plugs in directly. Key toward U1.
F32-F35 = A16-A19 (U2 GPB4-GPB7). Cards up to 1 MB.
F3/F36 (Vcc) and F1/F38 (GND) are joined inside the card.
BATT-DET pull-down: no battery 0.24 V, new battery 2.75 V
USE_SPI_SRAM (auto-detected)
USE_SD. 3.3 V regulator + level shifter on module
(pin order differs by module)
USE_LCD (auto-detected)
Bypass capacitors: C1 U1, C2 U2, C3 U3 (0.1u ceramic). C4 10u bulk near the card (card supply)
FUJISOKU SRAM Utility - Arduino UNO R4 shield
Single 5 V supply from the Arduino 5V pin. All parts are 5 V, no level shifting.
SPI (D13 SCK, D12 MISO, D11 MOSI) is shared by both MCP23S17, the SPI SRAM and the SD card module.
Labels with the same name are connected. Source: docs/hardware.md, FUJISOKU_SRAM_COPY/config.h (v3.0).
Shield board: DIP parts in sockets. The card slot unit plugs into J1 (keyed MIL socket).

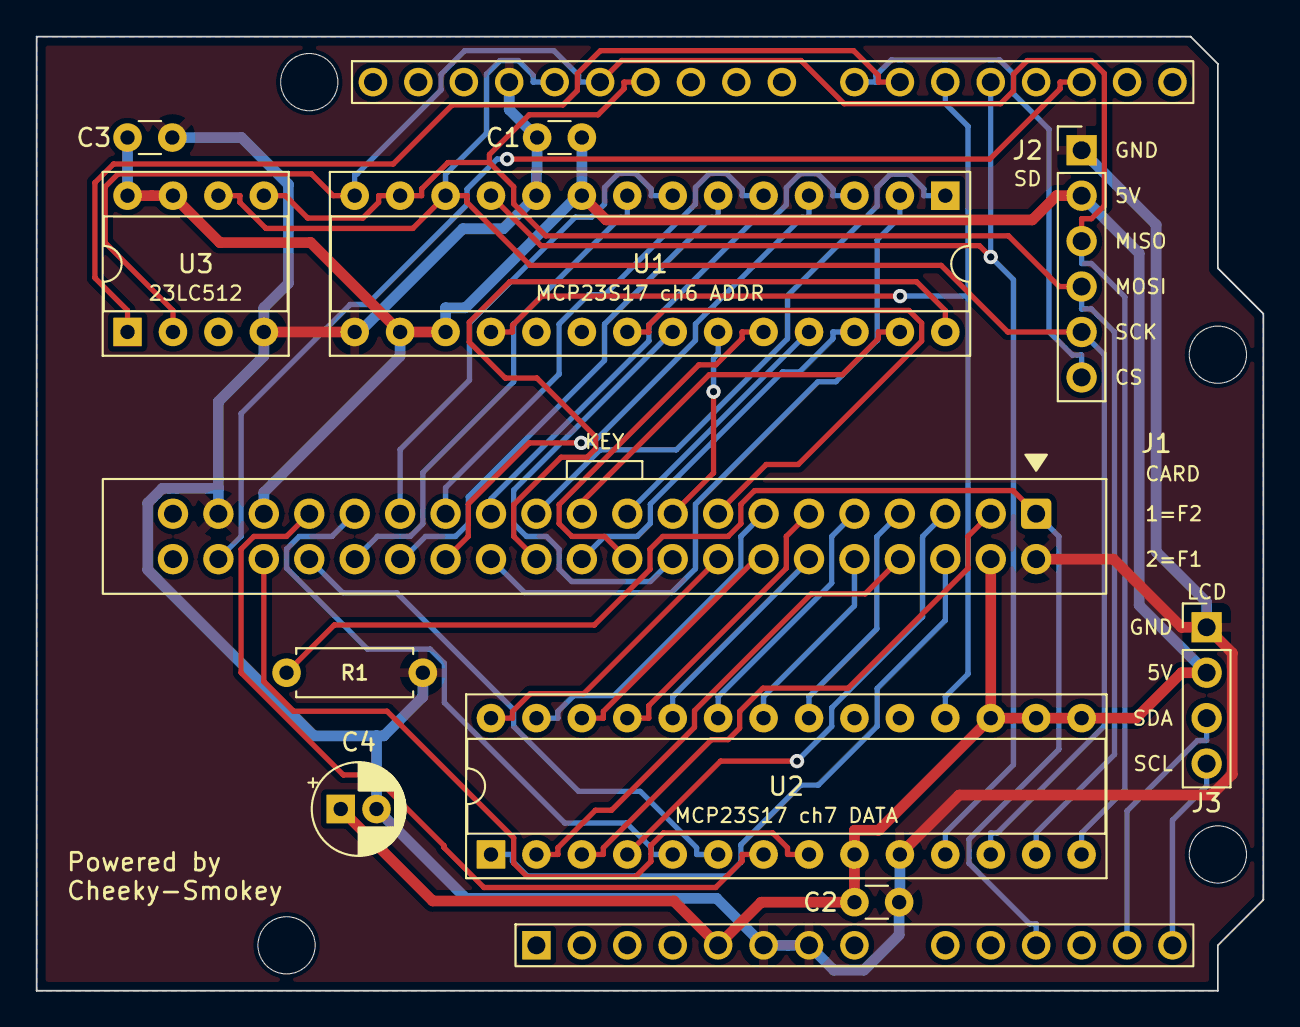
[picture p13: board FSU_Shield.kicad_pcb from above]

Board: 2 copper layers, 68.6 x 53.3 mm, 12 parts (0 on the bottom side), 45 nets.
