cheeky-smokey/FUJISOKU-SRAM-Utility/test/realhdr/Wire.h

#pragma once
#include "Arduino.h"
class TwoWire {
public:
  void begin();
  void setClock(uint32_t);
  void beginTransmission(uint8_t addr);
  uint8_t endTransmission(bool stop = true);
  size_t write(uint8_t b);
};
extern TwoWire Wire;
