cheeky-smokey/FUJISOKU-SRAM-Utility/(commit log)

2026-11-06 Add FUJISOKU SRAM utility sketch
    Serial-command utility (115200 bps) that copies and verifies the 32 KB
    contents of a Silver Reed FUJISOKU memory card between the card, an SPI
    SRAM and an SD card (fujisoku.bin).
    Commands: R/C (card <-> SPI SRAM), S/W (SPI SRAM <-> SD),
    B/L (card <-> SD), X (compare card / SPI SRAM), V (verify SD / card),
    T (SPI SRAM self-test).
    Claude-Session: https://claude.ai/code/session_01UJuSgzhm1N2XSN85DYFj5Y
2026-11-06 Add hardware connection diagram, specifications and README
    - docs/images/hardware-connection.svg: connection overview derived from
    the sketch (Arduino, SPI devices, MCP23S17 ch6/ch7, FUJISOKU, 62256)
    - docs/hardware.md: pin map, MCP23S17 bit assignments, access sequences
    - docs/specification.md: commands, file format, function reference
    - README.md: overview, build notes and links
    Items that cannot be determined from the code are listed as "to confirm"
    in docs/hardware.md section 9.
    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
2026-11-06 README.md を更新
2026-11-06 Redo hardware diagrams and specifications from the wiring and pin-out articles
    - Redraw the connection overview (Arduino UNO R4, MCP23S17 x 2, p11 /CS, p18 /RESET)
    - Add the MCP23S17 - FUJISOKU card wiring diagram (F1-F38)
    - Rewrite hardware.md: card pin-out, signal-to-MCP wiring table, register trace,
    and the ch7 port B control-bit mismatch between the article and the sketch
    - Rewrite specification.md as a detailed code specification
    - Update README.md (MCP count is 2, not 8)
    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
2026-11-06 v2.1: Web app, 20x4 LCD UI, SD hot-swap, optional LCD / 62256
    - Split the sketch into tabs (config.h, hardware, storage, operations,
    protocol, lcd_ui) with a line-based serial protocol (docs/protocol.md)
    - SD card: remount at every SD command, no halt without a card, safe
    hot-swap between commands, SDLOST / SDERR on removal mid-operation,
    backups written to a temp file and renamed (old backup survives)
    - Restart the shared SPI after SD.end() (UNO R4 SdFat stops it) and wrap
    every MCP23S17 / SPI SRAM access in SPI.beginTransaction (4 MHz)
    - Release the address/data bus after every operation (bus_idle)
    - SPI SRAM set to byte mode at boot (stops MCP-path junk writes)
    - Display: 20x4 cha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
    [Arduino.h, FUJISOKU_SRAM_COPY.ino, Print.h, SPI.h, SdFat.h, Wire.h, config.h, hardware.ino]
2026-11-07 v2.2: make the SD card optional (USE_SD)
    The web app can read, write and compare the card, so the SD card is now
    an optional part like the LCD.
    - config.h: USE_SD (default 1). With 0, storage.ino and the SD
    operations are not compiled and SdFat is not needed; sd / sdcheck and
    B L V S W reply "ERR DISABLED", status reports sd=-, the display shows
    SD:off. D7 is still driven high so an attached module stays quiet.
    - hello reports sdcard=1|0; the web app hides the SD tab when it is 0
    - With USE_SD=0 and USE_LCD=0 the sketch needs no external library
    - Tests: USE_SD=0 build, firmware and web app tests, real-header checks
    without SdFat and without any library (53 tests pass)
    - Docs: hardw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
2026-11-07 v2.3: SPI SRAM /CS is D6 only; code review fixes and readability
    Hardware
    - SPI SRAM /CS is wired to Arduino D6 only. Remove the MCP23S17 ch7 GPB5
    path (read/write, self-test, boot-time byte mode). GPB5 is now unused.
    Fixes found in review
    - rd/wr/fill: the range check could be bypassed by 32-bit overflow of
    addr + len (e.g. "rd f 0xFFFFFFF0 0x20"), reaching A16/A17 addresses.
    - config.h: SPI SRAM page/sequential mode constants were swapped.
    - Card/62256 write: put data on the bus before /WE goes low, so the
    previous byte is no longer briefly written while /WE is low.
    - 62256 bus test: comments on stuck-high/low did not match the logic.
    Readability and speed
    - Named control bits (CTR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
    [FUJISOKU_SRAM_COPY.ino, config.h, hardware.ino, lcd_ui.ino, operations.ino, protocol.ino, sim.cpp, storage.ino]
2026-11-07 Make USE_SD default 0 and replace the README banner
    - config.h: USE_SD now defaults to 0 (no SD card, no SdFat needed).
    Card backups go to the PC through the web app; set USE_SD 1 to use
    an SD card module.
    - Tests build the main simulator with -DUSE_SD=1 explicitly; the
    default config (SD off) is covered by fsu_sim_nosd and the real-header
    check. 53 tests pass, 5 real-header configurations pass.
    - README, hardware.md, specification.md, protocol.md, webapp.md and
    test/README updated for the new default.
    - docs/images/banner.png replaced with the new illustration.
    Claude-Session: https://claude.ai/code/session_01UJuSgzhm1N2XSN8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
    [config.h]
2026-11-07 v2.4: read and write cards larger than 32KB from the web app
    Firmware
    - rd/wr/fill ranges are per target: card 0x00000-0x3FFFF (A0-A17,
    256KB), SPI SRAM 64KB, 62256 32KB. On-device copy/compare/SD stay 32KB.
    - hello reports cardmax=262144; D lines use 5 hex digits above 0xFFFF.
    Web app
    - Read size buttons 32KB (default) / 64KB / 128KB / 256KB on the save
    tab; larger sizes are disabled for firmware without cardmax. Files
    saved at other sizes get a _64KB style suffix. Reading a 32KB card
    at a larger size reports that the content repeats.
    - Write accepts 32KB-256KB files. Files larger than 32KB show a warning
    with "first 32KB only" / "all" / cancel, explaining that a 32KB card
    wrap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
2026-11-07 v2.5: make the SPI SRAM optional (USE_SPI_SRAM, auto-detected)
    - New option USE_SPI_SRAM (default 1). At boot spi_sram_init() writes
    byte and sequential mode and reads each back; the SPI SRAM counts as
    present only if both match. When absent, SPI SRAM operations return
    ERR NOSPI; "test" still runs and re-detects. With USE_SPI_SRAM 0 the
    SPI SRAM code is left out and target s / R C X E S W T return
    ERR DISABLED. D6 stays high either way.
    - dev_ready() checks every target before a command runs; a disabled
    62256 target now returns ERR DISABLED instead of ERR ARG.
    - hello reports spisram=ok|none|off, the boot banner adds
    "SPI SRAM ok|none|off", status shows spi=- when disa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
2026-11-07 Add reference photos of the memory card slot
    - docs/images/slot-adapter-akizuki.jpg: Akizuki 10-pin 2.54 mm (2x5) to
    1.27 mm (1x10) adapter boards and how they connect the slot pins to
    the 40-pin two-row header.
    - docs/images/slot-extender.jpg: the slot on a perfboard with a card.
    - hardware.md §12.1 shows both photos; README links to it.
    Photo metadata (EXIF) was removed.
    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
2026-11-07 docs: record confirmed hardware details (5 V, addresses, parts)
    Confirmed by the board owner and recorded in hardware.md:
    - Single 5 V supply; every part is 5 V, so no level shifting.
    - Card power: F3/F36 = Vcc (5 V), F1/F38 = GND, each pair joined inside
    the card.
    - MCP23S17 A2:A0 equal the channel number (ch6 = 110, ch7 = 111).
    - SPI SRAM is a Microchip 23LC512.
    - LCD backpack address 0x27 (sketch default) works on the board.
    - D3 (PIN_MCP_INT) is not connected; interrupts are not used.
    - Data lines D0-D7 = ch7 GPA0-GPA7; D2/D3 in the article table is a typo.
    hardware.md gains §2.1 (power and levels) and §13 now lists every item
    as confirmed. README, both diagrams and two config.h com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
2026-11-07 docs: SD card module is a 5 V type with level shifting (confirmed)
    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
2026-11-07 Release v2.5 (beta -> release)
    - Banner: "ベータ版" -> "リリース版" and the "Beta" ribbon -> "Release".
    - README states release v2.5 and links to Releases.
    - specification.md: v2.5 marked as the release; the SPI SRAM option
    change is now confirmed on the real board.
    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
2026-11-07 v2.6: card detect (D2) and card battery voltage (A0)
    Firmware (new card.ino)
    - /CARD DET (card F37) on D2 with the internal pull-up; low = card in
    (CARD_DET_ACTIVE_LOW). 50 ms debounce, "E CARD 1/0" on change.
    Without a card, card commands (rd/wr/fill f, copy, cmp, erase f,
    sd save/load/verify f, R C X B L V e) return ERR NOCARD. If the card
    is pulled during an operation it stops with "ERR NOCARD Card removed
    at 0x....", and the bus goes back to idle.
    - BATT-DET (card F2) on A0: 12-bit, 8-sample average every 0.5 s,
    reported as "E BATT <mV>" on 50 mV changes or when crossing the
    warning level. Warning at or below BATT_LOW_MV (1000 mV). Not measured
    without a card.
    - Options U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
2026-11-07 Move BATT-DET from A0 to A2
    The card's BATT-DET (F2) is now wired to Arduino A2 instead of A0.
    PIN_BATT_DET = A2; A0 is free again. Code comments, hardware.md
    (pin table, §6.1, §13), specification.md, README, both diagrams and
    the test names updated. 63 tests pass, 5 real-header configurations
    pass.
    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
2026-11-07 Web app: remove or replace a chosen file in the drop zones
    - The write and compare file boxes get a "×" button that removes the
    chosen file (disabled while busy). It does not open the file picker.
    - After a file is chosen the input is cleared, so choosing the same
    file again (e.g. a re-exported file with the same name) works.
    - A hint under the file says it can be replaced by click or drop.
    - New web test; 64 tests pass. webapp.md and the v2.6 history updated.
    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
2026-11-07 docs: note the file box remove button in the v2.6 history
    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
2026-11-07 docs: README shows v2.6 as the latest version and the file box remove button
    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
2026-11-07 docs: v2.6 confirmed on the real board (card detect D2, battery A2)
    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
2026-11-07 v2.7: detect a missing card battery (A2 with 1 MOhm to GND)
    Without a battery the card's BATT-DET line floats and leakage inside
    the card lifts it to 3-4 V (3.6 V seen on the real board). With a
    1 MOhm resistor from A2 to GND the board reads 0.24 V with no battery
    and 2.75 V with a new battery.
    - BATT_NONE_MV (default 400): at or below it the battery counts as
    missing (batt_none()). LCD shows "Bat:NONE!" and "! No card battery !";
    the web app shows "なし" with a warning that the data is lost once the
    card is removed. Crossing 0.40 V also sends E BATT.
    - hello adds battnone=400. Version 2.7.
    - Simulator: no card reads 0 V (pull-down). Tests cover the none state
    in firmware, LCD and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
    [card.ino, config.h, lcd_ui.ino, protocol.ino, sim.cpp]
2026-11-07 v2.7: low battery at 2.00 V and a (c) signature on the LCD
    - BATT_LOW_MV 1000 -> 2000. A new battery reads 2.75 V on the board
    (1 MOhm on A2), so 2 V matches the usual replacement point of a coin
    lithium cell. "No battery" stays at 0.40 V or below.
    - LCD: every screen shows a custom-character (c) at the bottom right
    (row 4, column 20). Row-4 text is kept to 19 characters: progress
    "0x3B00/8000 3.2k/s", result "Time 00:02 NOSD", idle battery
    warnings "! Card battery low" / "! No card battery", Last: one shorter.
    The progress bar's empty cells now use the ROM '_' so a CGRAM slot is
    free for the (c). The web app's LCD mirror draws the same glyph.
    - Tests updated; 64 tests pass in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
    [config.h, lcd_ui.ino]
2026-11-07 Web app: show write/verify progress per phase (32KB no longer looks like 64KB)
    The write progress used the sum of written and verified bytes as its
    total, so a 32KB write with verify showed 65,536 bytes and "64K" on the
    LCD (64KB showed 131,072 / 128K). Only the file size is actually
    written; counting the commands sent in the simulator gives wr = 65,536
    and rd = 65,536 for a 64KB file, with the card matching the file.
    - The byte counter now shows the current phase (write, verify, read
    1/2, read 2/2); the percentage and time left still cover the whole job.
    - The LCD gets a fresh "ui begin" per phase (PC_to_Card, Verify, each
    read pass), so it counts up to the phase size (0x8000 for 32KB)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
2026-11-07 docs: v2.7 confirmed on the real board
    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
2026-11-08 v2.8: battery thresholds No battery 0.50 V / Low battery 1.50 V in config.h
    - BATT_NONE_MV = 500 (No battery) and BATT_LOW_MV = 1500 (Low battery),
    moved to the top of config.h right below USE_BATT_DET with a table of
    how each range is judged and the measured values (0.24 V without a
    battery, 2.75 V with a new one).
    - static_assert stops the build if BATT_NONE_MV is not lower than
    BATT_LOW_MV.
    - hello reports battlow=1500 battnone=500. Version 2.8.
    - Tests updated (values just inside each boundary because of 12-bit
    rounding); 65 tests pass, 5 real-header configurations pass.
    - README, hardware.md, specification.md (v2.8 history), protocol.md,
    webapp.md and the diagram title updat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
2026-11-08 Release v2.8: confirmed on the real board
    README shows release v2.8; specification.md, hardware.md and test
    README record that v2.8 is verified on the author's board.
    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
2026-11-08 docs: add card battery types (CR2016 / BR2325) vs A2 measurement
    - hardware.md 6.1: measured relation between the A2 reading and the
    battery voltage display, per battery type (ratio ~1.20 for CR2016,
    ~1.14 for BR2325), and what the No battery / Low battery thresholds
    correspond to
    - hardware.md 13: add the battery types to the confirmed items
    - specification.md 6.4: note that batt_mv is the raw A2 reading with no
    per-battery correction
    Documentation only; the release number stays at v2.8.
    Claude-Session: https://claude.ai/code/session_01UJuSh2du8qDJWUNgGazZTB
2026-11-08 docs: the battery reference values are tester readings
    Reword the CR2016 / BR2325 vs A2 table: the second column is the
    voltage measured with a tester, not a display value. Note that
    BATT_ADC_FULL_MV cannot match both battery types because the ratio
    differs per type.
    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
2026-11-08 Raise BATT_LOW_MV from 1500 to 1700 mV
    The measured relation between the A2 reading and the tester voltage
    (CR2016: tester = 1.203 x A2, BR2325: tester = 1.141 x A2) puts an A2
    reading of 1.70 V at about 2 V on the tester (CR2016 ~2.05 V,
    BR2325 ~1.94 V), so Low battery now warns at about 2 V for both types.
    - config.h: BATT_LOW_MV 1700
    - hello now reports battlow=1700
    - docs (README, hardware, specification, webapp, protocol) and the
    firmware / web tests follow the new threshold
    - specification 5.x LCD row: fix the stale 2.00 V / 0.40 V to 1.70 V / 0.50 V
    The value is extrapolated from readings of 2.34 V and above and is not
    yet confirmed on the real board. The release number stays at v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
    [config.h]
2026-11-09 docs: add A2 vs tester relations for CR2016 / BR2325 to hardware.md 6.1
    - both directions of the through-origin fits per battery type
    (CR2016: tester = 1.203 x A2, A2 = 0.831 x tester;
    BR2325: tester = 1.141 x A2, A2 = 0.876 x tester)
    - max difference from the readings (+-0.034 V / +-0.036 V), number of
    points and the measured A2 range per group
    - chart (docs/images/battery-a2-vs-tester.png) with the extrapolation
    down to BATT_LOW_MV
    - threshold conversion tables (A2 1.70 V / 1.50 V -> tester value,
    tester 2.00 V -> A2 value); marked as extrapolated, not yet checked
    on the real board
    - fix the BR2325 ratio range to 1.13-1.15 (was 1.14-1.15) and a stray
    space
    Documentation onl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
2026-11-12 Add a KiCad schematic of the hardware
    hardware/kicad/ holds a KiCad 7 schematic (opens in 8 / 9) drawn from
    docs/hardware.md and config.h v2.8:
    - Arduino UNO R4, MCP23S17 ch6 (A0-A15, A2:A0 = 110) and ch7 (D0-D7,
    control lines, A16/A17, A2:A0 = 111), card slot F1-F38, /CARD DET on
    D2, BATT-DET on A2 with the 1 MOhm pull-down.
    - Optional parts: 23LC512 SPI SRAM (D6), 62256 (/CS = CE2), SD card
    module (D7), 20x4 LCD with PCF8574 (I2C 0x27).
    - Recommended 0.1 uF bypass capacitors (not in the spec, marked so).
    gen_schematic.py rebuilds the schematic from the KiCad standard symbol
    libraries; check_netlist.py compares the exported netlist with the
    wiring tables (all nets OK). A3 PDF and a P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
    [FUJISOKU_SRAM_Utility.kicad_sch]
2026-11-13 Add an Arduino UNO R4 shield PCB (KiCad) with Gerbers
    - gen_schematic.py --shield: shield schematic (no 62256, DIP sockets,
    J1 = 40-pin box header: pin 2k-1 = F2k, pin 2k = F2k-1, 39/40 NC)
    - gen_pcb.py: builds the 2-layer 68.6 x 53.3 mm board, autoroutes with
    Freerouting (retries until fully routed), GND pours, DRC, checks the
    copper nets against docs/hardware.md, exports Gerber zip, 1:1 PDF, images
    - FSU:Arduino_UNO_R4_Shield footprint (KiCad's Module:Arduino_UNO_R3 is
    drawn mirrored for shield use)
    - check_netlist.py --shield; docs: hardware.md 2.3 / 12.2 / 13, READMEs
    DRC: 0 violations, 0 unconnected. 6 vias.
    Claude-Sessio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
    [FSU_Shield.kicad_pcb, FSU_Shield.kicad_sch]
2026-11-13 Tie card F34 (A18) and F35 (A19) to GND
    They must not be left open. Schematic (J1 pins 34/35 on the full
    schematic, header pins 33/36 on the shield), shield PCB re-routed
    (DRC 0, unconnected 0, 10 vias), check_netlist.py now requires them on
    GND, docs (hardware.md 5 / 6 / 12.2 / 13, wiring diagram, READMEs).
    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
    [FSU_Shield.kicad_pcb, FSU_Shield.kicad_sch, FUJISOKU_SRAM_Utility.kicad_sch]
2026-11-13 Shield J1: keyed MIL female socket for the slot unit
    The card slot unit (slot taken from a U-BOX, four Akizuki 2x5/1x10
    adapters mounted upside down, right-angle keyed 2x20 box header) now
    plugs straight into J1 instead of using a ribbon cable. The box header
    notch takes the socket key, so it cannot be plugged in reversed.
    - FSU:MIL_Socket_2x20_P2.54mm_Vertical footprint (same pads/numbering as
    the IDC header, key on the odd-pin side = U1 side, mated box header
    outline on F.Fab and as courtyard); KEY silkscreen
    - schematic and PCB regenerated: DRC 0 violations, 0 unconnected,
    board nets checked against docs/hardware.md
    - docs: hardware.md 2.3 / 12.1 / 12.2 (slot unit, U-BOX connection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
    [FSU_Shield.kicad_pcb, FSU_Shield.kicad_sch]
2026-11-14 v3.0 (wo62256): 62256 をやめ、カードの F32-F35 (A16-A19) を ch7 GPB4-GPB7 へ
    - ch7 GPB: B0 CE2, B1 /OE, B2 /CE1, B3 /WE, B4-B7 A16-A19
    - カードの範囲を 1MB (A0-A19) に。62256 (USE_SRAM62256, 対象 p, test p) を削除
    - Web アプリ: 512KB / 1MB の読み込み、32KB-1MB の書き込み
    - KiCad: 回路図とシールド基板 (rev 2.0) を新しい割り当てで再生成 (DRC 0, 未配線 0, ビア 6)
    - シミュレータ・テストを更新 (4 構成, 64 件すべて通過)
    - 仕様書・README を更新。実機ではまだ確かめていない
    Claude-Session: https://claude.ai/code/session_01UJuSgzhm1N2XSN85D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
    [FSU_Shield.kicad_pcb, FSU_Shield.kicad_sch, FUJISOKU_SRAM_Utility.kicad_sch]
2026-11-14 Shield silk: "Powered by Cheeky-Smokey" at the lower left (front)
    - 部品面の左下 (取り付け穴と C4 の間) に 1.0 mm の文字で追加
    - 裏面の名前を rev 2.0 に (回路図の rev と合わせる)
    - gen_pcb.py --retext: 配線はそのままでシルクだけ書き直して出力し直す
    - 配線は変えていない (DRC 0、未配線 0、結線は仕様書どおり)
    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
    [FSU_Shield.kicad_pcb]
2026-11-14 Shield silk: break the credit line before "Cheeky-Smokey"
    - 「Powered by」「Cheeky-Smokey」の 2 行にして、取り付け穴の上・C4 の左へ
    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
    [FSU_Shield.kicad_pcb]
2026-11-14 Web app: write-size buttons (32KB-1MB); tests for 256KB/512KB/1MB
    - 書き込む大きさのボタン (32KB / 64KB / 128KB / 256KB / 512KB / 1MB)。既定はファイルの大きさ、
    それ以外の大きさのファイルは「全体」。ファイルや cardmax より大きいボタンは押せない
    - 「先頭 32KB だけ / すべて」のダイアログをやめ、32KB より大きく書くときは警告の確認ダイアログ
    - テスト: 1MB のカードを 256KB / 512KB / 1MB で読み、1MB のファイルから 256KB / 512KB / 1MB を
    書き込んで照合。「全体」のテストを追加 (Web アプリ 27 件すべて通過、全体で 66 件)
    - 仕様書 (webapp.md / s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
2026-11-14 Web app: keep the "first 32KB only / all" choice with the write-size buttons
    - 書き込む大きさが 32KB より大きいときは、従来どおり「先頭 32KB だけ書き込む」か
    「すべて書き込む (選んだ大きさ)」かを警告ダイアログで選ぶ
    - テストと仕様書 (webapp.md / specification.md / protocol.md)、README を合わせた
    (Web アプリ 27 件すべて通過)
    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
